jammendolia/CoolLamp/hardware/pcb/rev-a/review/CoolLamp-RevA.pdf

1 | 2 | 3 | 4 | 5 | 6 | 7 | 8
1 | 2 | 3 | 4 | 5 | 6 | 7 | 8

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
Size: A3 | Rev: A1-DRAFT | F Date: 2026-09-30
KiCad E.D.A. 10.0.6 | Id: 1/1

# Title: CoolLamp Rev A — review schematic

# File: CoolLamp-RevA.kicad_sch

# Sheet: /

# NOT FOR FABRICATION

1

1 | TP1 GPIO1 reference
5V 1 | DIN 2 | GND

# 3 J2 WS2812B strip R5

# 22R candidate R4

### 22R candidate C4

100nF | SW2 BOOT R3

10k

GPIO20_RX 1 | GPIO21_TX 2 | GND | 3 J4 UART recovery R2

10k

GND 1 +

2

SW 3 | DT | 4 CLK | 5 ENC1 HW-040 breakout | SW1 RESET
GND 1 | GND 2
3V3 3 | NC 4 | GPIO2 5 | GPIO3 6 | NC 7
EN 8 | NC 9 | NC 10 | GND 11 | GPIO0 12 | GPIO1 13 | GND 14 | NC 15 | GPIO10 16 | NC 17 | GPIO4 18 | GPIO5 19 | GPIO6 20 | GPIO7 21 | GPIO8 22 | GPIO9 23 | NC 24 | NC 25 | GPIO18 26 | GPIO19 27
NC | 28 NC | 29 GPIO20 | 30 GPIO21 | 31 NC | 32 NC | 33 NC | 34 NC | 35 GND | 36 GND | 37 GND | 38 GND | 39 GND | 40 GND | 41 GND | 42 GND | 43 GND | 44 GND | 45 GND | 46 GND | 47 GND | 48 GND | 49 GND | 50 GND | 51 GND | 52 GND | 53 U1

### ESP32-C3-MINI-1 (4MB TBD)

F1

Fuse: rating TBD

C3

10uF

3V3 1 | GND 2
SCK 3 | WS

4

SD

5 J3

### INMP441 daughterboard

VBUS 1 | D- 2 | D+ | 3 GND | 4 J1

### Existing panel USB-C

C5

# 1uF R1

10k

### PWR 1#FLG02

Supply return R6

### 10k OPTIONAL

### PWR 1#FLG01

### External 5V C2

### 1uF C1

1uF

VIN 1 | GND 2
EN 3 | NC | 4
VOUT | 5 U2

### AP2112K-3.3 candidate

R8

### 10k OPTIONAL R7

### 10k OPTIONAL

MIC_SD

USB_DP_PORT | MIC_WS MIC_SCK +3V3
GND +3V3 | ENC_SW

+3V3 GND

GND +3V3

LED_DATA_3V3 GND | +5V_SYS +5V_SYS | +3V3

USB_DP_PORT GND

USB_DP_CHIP +3V3

USB_DM_PORT +5V_SYS

USB_DM_CHIP

GND +3V3

ENC_A | BOOT_N

ENC_B

GND

GND | +3V3 GND

BOOT_STRAP8 GND

GND

GND

GND

GND

GND

GND

LED_DATA_3V3 | GND

ENC_REF_GPIO1 GND

GND

GND

ENC_A | GND MIC_SCK MIC_WS MIC_SD

BOOT_STRAP8 BOOT_N

GND

GND

GND

GND

GND USB_DM_CHIP

GND USB_DP_CHIP

CHIP_EN

GND

GND +3V3 +3V3

BOOT_N

# GND +3V3

CHIP_EN

GND

ENC_B

UART_RX

UART_TX

UART_TX

UART_RX

ENC_REF_GPIO1

ENC_SW

CHIP_EN

+3V3

GND

GND

ENC_B

GND

GND

CHIP_EN

ENC_REF_GPIO1

USB_DM_PORT | +5V_SYS

VBUS_IN

VBUS_IN

ENC_A

+5V_SYS | GND +5V_SYS

ENC_SW

# 3. USB / LED / MICROPHONE

USB ESD network still to select. No CC wires at existing inlet. 4. HW-040 ENCODER BREAKOUT

HW-040: R2/R3 10k fitted; R1 appears unpopulated. GPIO1 feeds +; CLK=GPIO4, DT=GPIO3, SW=GPIO2. Verify resistor routing / SW bias. R6-R8 remain DNP.

LED count remains configurable (1–1024 software range). Approx. 132 LEDs expected for helix; current limit is separate. Mechanical: breakout mounting stack must be remeasured. Mic board: 3.3V, local decoupling, L/R=GND. Acoustic port and mic sourcing require review. No level shifter added to prototype LED path. RELEASE BLOCKERS HW-040 header footprint, SW bias and GPIO2 boot behaviour Exact module footprint / antenna placement and mic sourcing USB ESD, input protection, inrush, current limits and thermals

## LED data margins; connector ratings; schematic/PCB review

5V / 2.4A adapter reference; LEDs share input. AP2112 loss = (5V-3.3V) x controller current. Protection/inrush and computer power budget NOT resolved.

## NOT FOR FABRICATION — encoder bias review, protection, sourcing and footprints

# COOLLAMP REV A — ELECTRICAL REVIEW DRAFT

1. POWER INPUT / 3V3 SUPPLY | 2. CONTROLLER — FIXED GPIO MAPPING
