jammendolia/CoolLamp/docs/design/assets/lamp-corkscrew.png

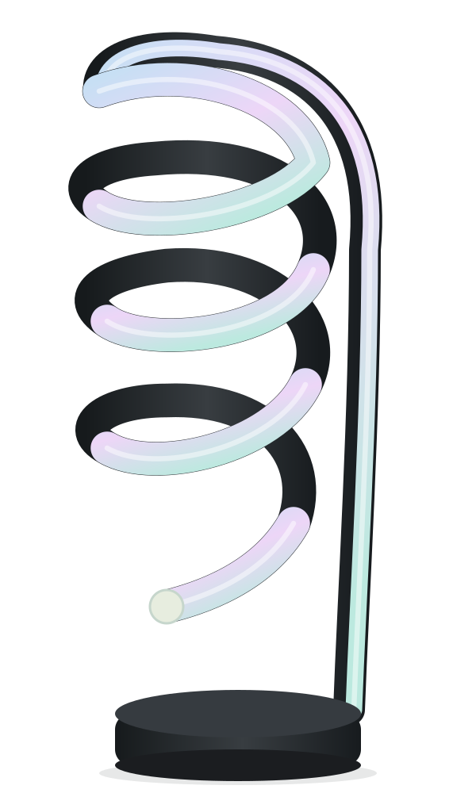
docs/design/assets/lamp-corkscrew.png
