jammendolia/CoolLamp/docs/design/assets/lamp-helix.png

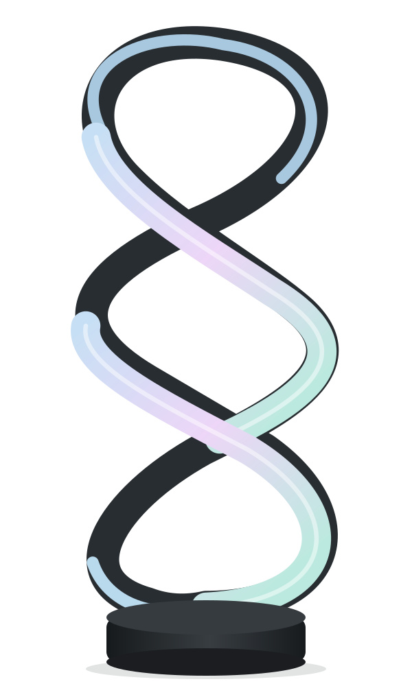
docs/design/assets/lamp-helix.png
