jammendolia/CoolLamp/docs/design/assets/lamp-knot.png

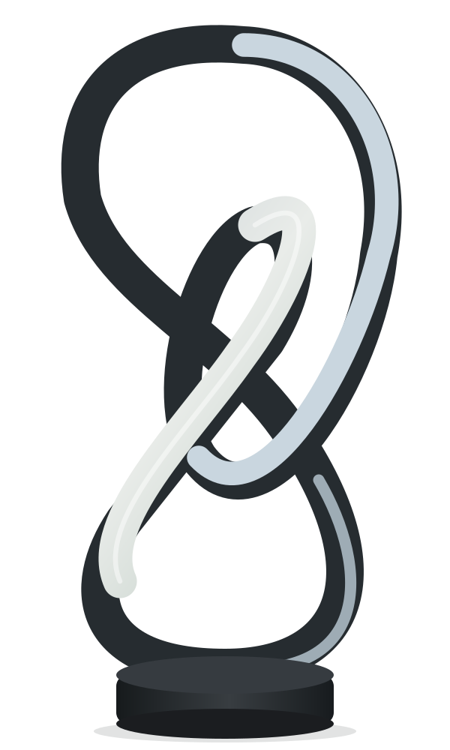
docs/design/assets/lamp-knot.png
