jammendolia/CoolLamp/docs/design/assets/lamp-large-helix.png

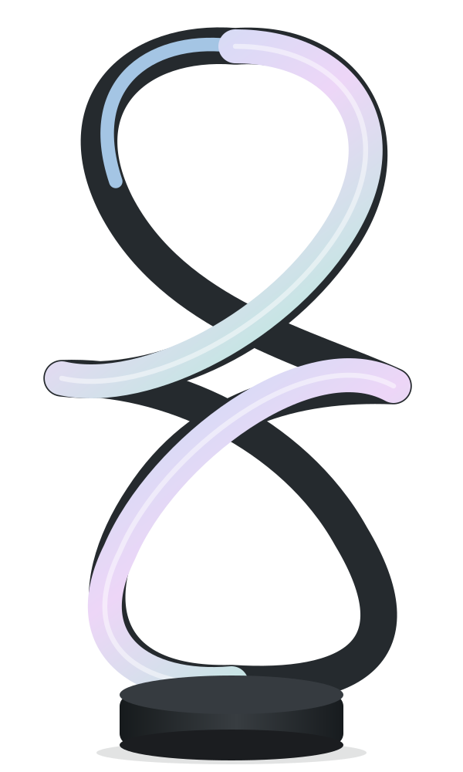
docs/design/assets/lamp-large-helix.png
