jammendolia/CoolLamp/docs/hardware/reference/hw040-front.jpg

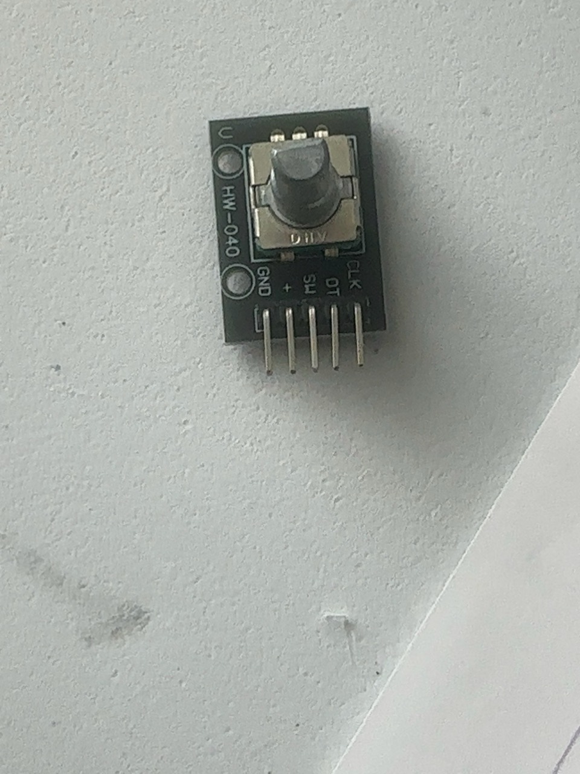
docs/hardware/reference/hw040-front.jpg
