jammendolia/CoolLamp/docs/hardware/reference/hw040-underside.jpg

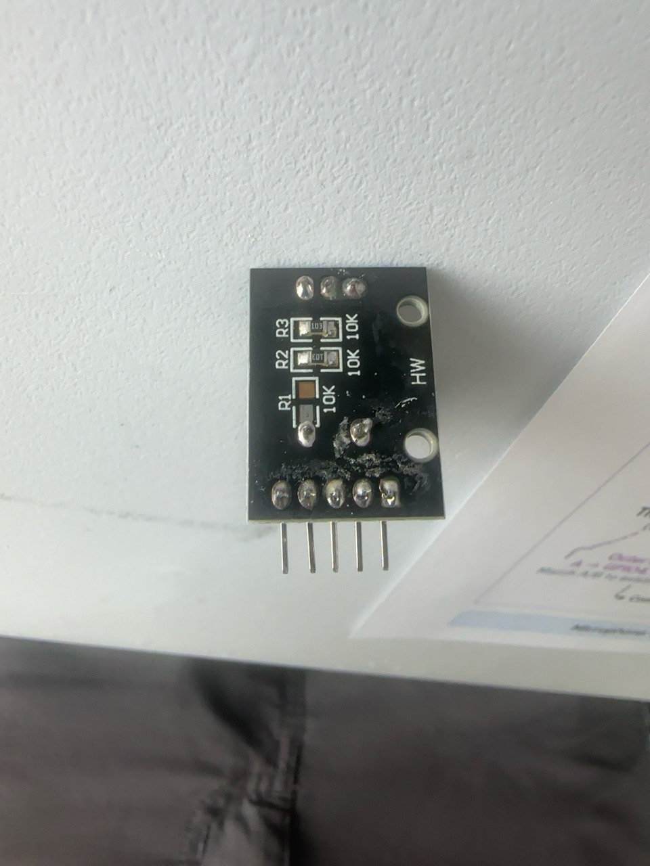
docs/hardware/reference/hw040-underside.jpg
