jammendolia/CoolLamp/docs/hardware/coollamp-microphone-encoder-wiring-prompt.md

# HW-040 wiring image — 2026-09-30

Generated using the built-in image tool, replacing the existing PNG at the user's request. Device depictions are AI-rendered from owner photographs; source photos are in `reference/hw040-front.jpg` and `reference/hw040-underside.jpg`. Pin ordering and connection labels were visually reviewed. No continuity or resistor-function measurement is claimed.

## Final prompt

Edit target: existing CoolLamp microphone + rotary encoder wiring image. Supporting reference photos: owner's HW-040 breakout top and underside. Use case: infographic-diagram. Replace the whole bare encoder lower panel with this actual HW-040 breakout: black rectangular board, silver encoder case, black shaft, two mounting holes, five header pins. Preserve upper ESP32-C3 SuperMini and round INMP441 photographic representations and their exact pinouts. Clean white print background, crisp large readable black text. Title "CoolLamp • microphone + HW-040 encoder". Subtitle "Firmware GPIO assignments preserved • September 2026".
Encoder front shown shaft toward viewer and five header pins pointing down: LEFT TO RIGHT exactly GND, +, SW, DT, CLK. Draw five unambiguous short leaders from those pins with mapping: GND → ESP GND (black), + → GPIO1 (red), SW → GPIO2 (orange), DT → GPIO3 (purple), CLK → GPIO4 (blue). Supply note "GPIO1: firmware-driven 3.3 V reference. Never connect + to 5 V." Include second small underside reference view showing R2 and R3 103 / 10K populated and R1 apparently empty. Note "R2/R3: 10 kΩ fitted. R1 appears unpopulated; verify SW pull-up." Do not invent resistors, wire onboard resistor routes, or claim continuity measured. Wiring is code-compatible assignment, not confirmed harness tracing. Short note "Match CLK/DT to existing turn direction; physical harness not traced."
Update ESP32 right-side labels GPIO4 encoder CLK, GPIO3 encoder DT, GPIO2 encoder SW, GPIO1 encoder +, GPIO0 LED DIN. Keep left top-to-bottom 5,6,7,8,9,10,20,21 and right top-to-bottom5V,GND,3V3,4,3,2,1,0. Microphone table and leaders exact: ESP3V3→VDD; GND→GND and L/R; GPIO5→SCK; GPIO6→WS; GPIO7→SD. GPIO0 LED DIN direct. Remove stale footer claiming audio firmware not implemented. Footer "Microphone: 3.3 V only • No GPIO changes • No LED level shifter". No bare-encoder contacts panel. No dark backgrounds. This is a technical wiring image; correct terminal count, ordering and leaders are more important than decorative style.
