jammendolia/CoolLamp/hardware/pcb/rev-a/CoolLamp-RevA.kicad_sch

## KiCad design hardware/pcb/rev-a/CoolLamp-RevA.kicad_sch (2026-10-06)

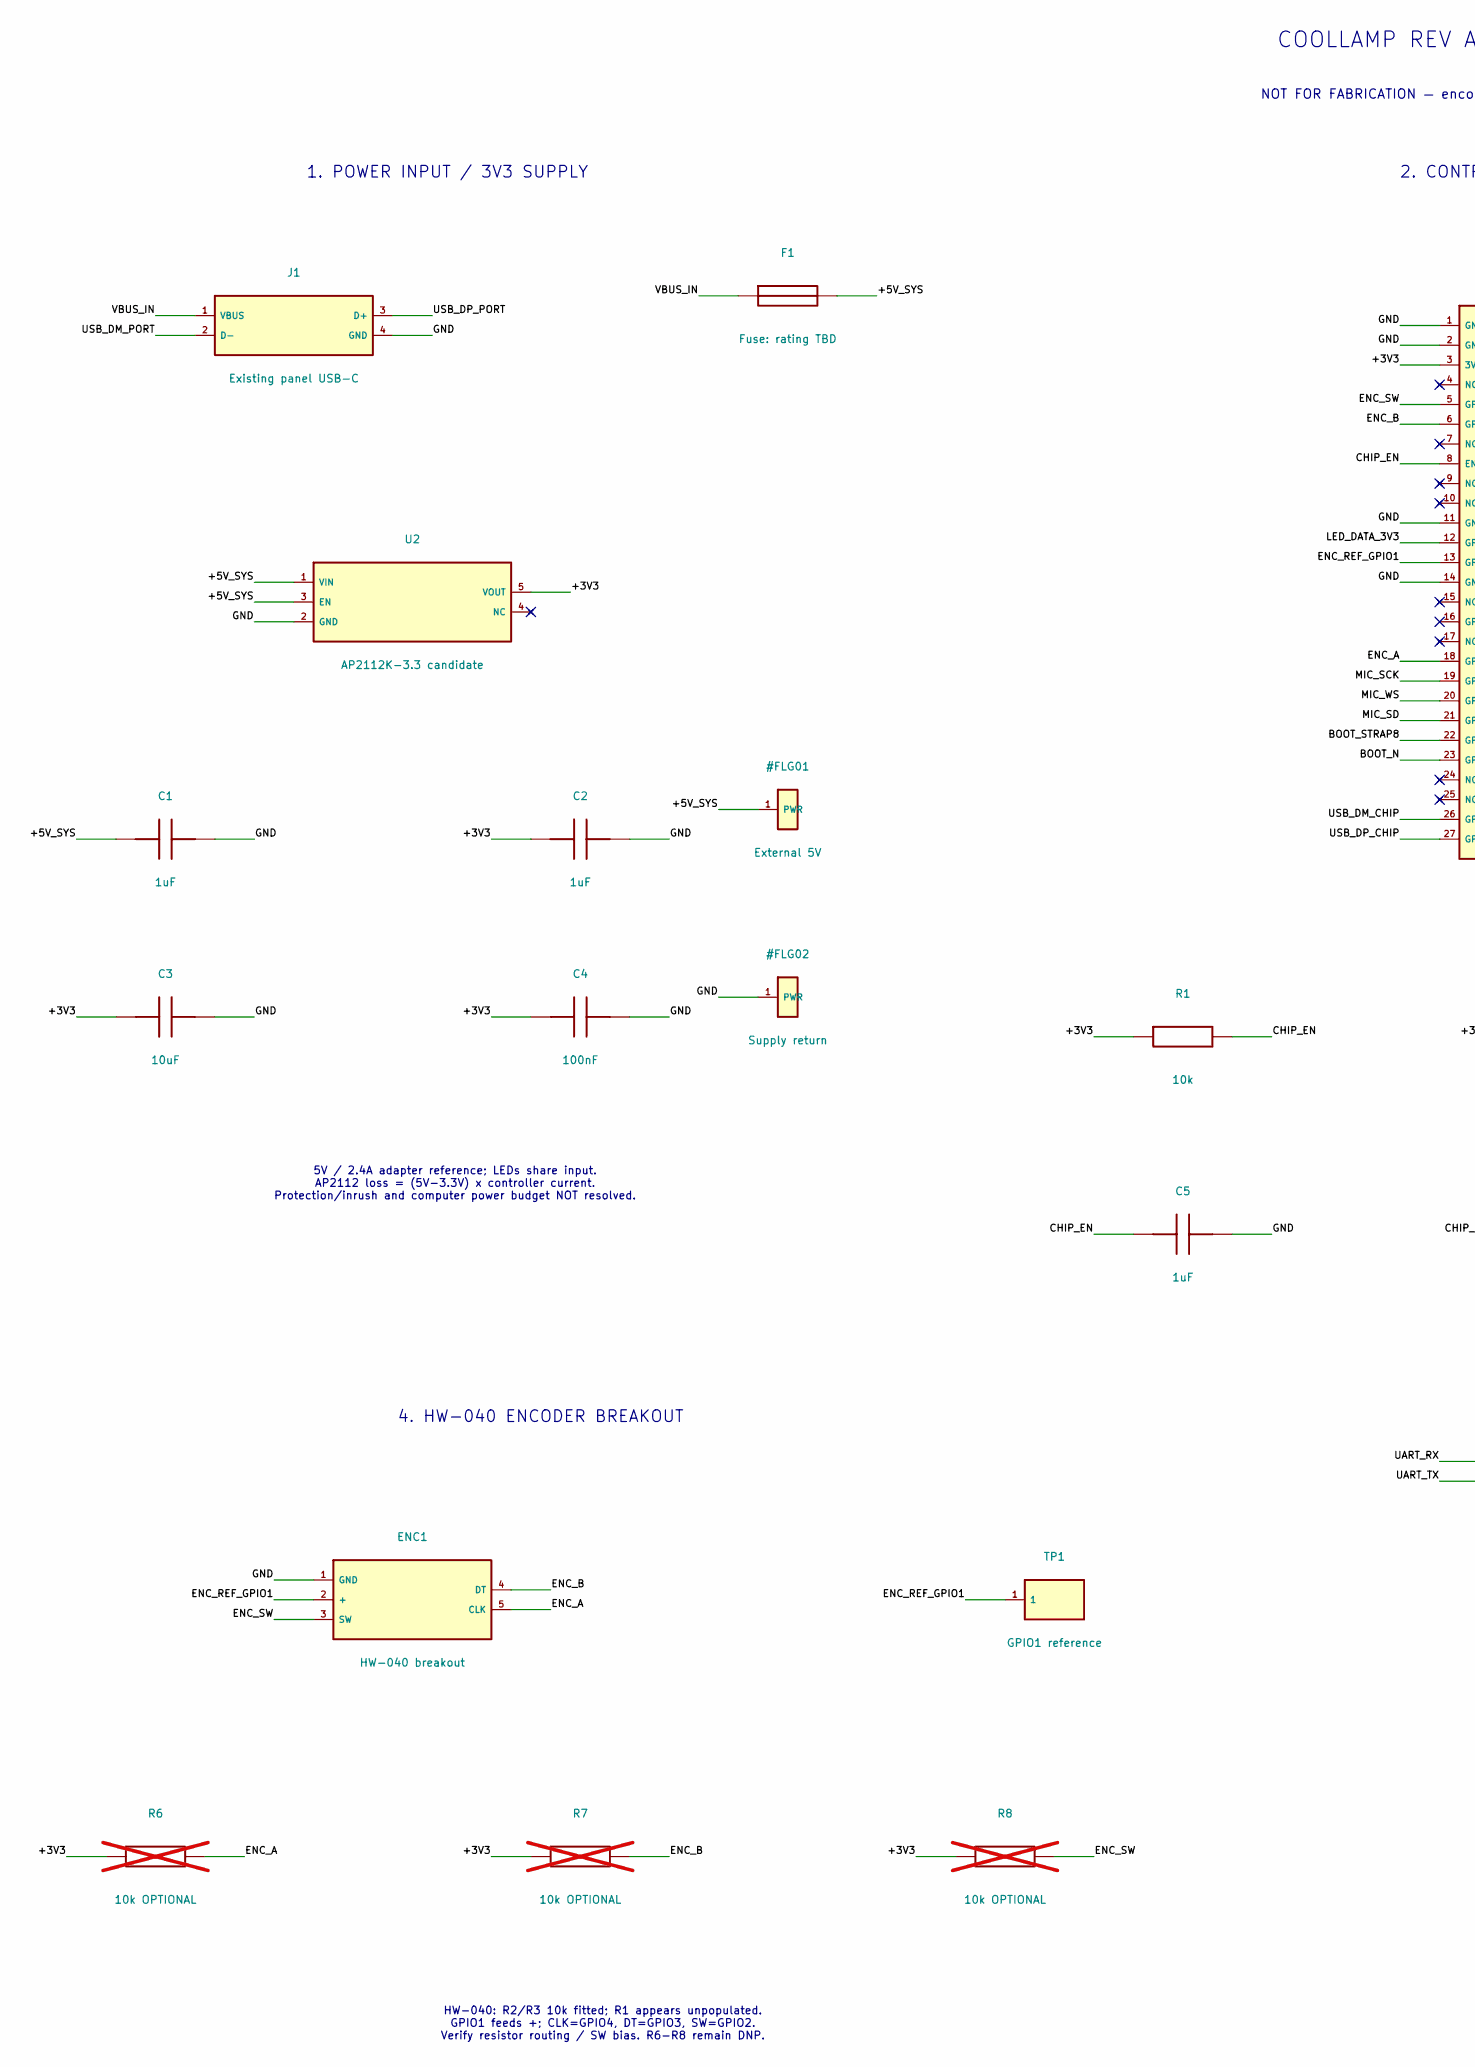
[picture p9: schematic CoolLamp-RevA.kicad_sch, part in row 1, column 1]

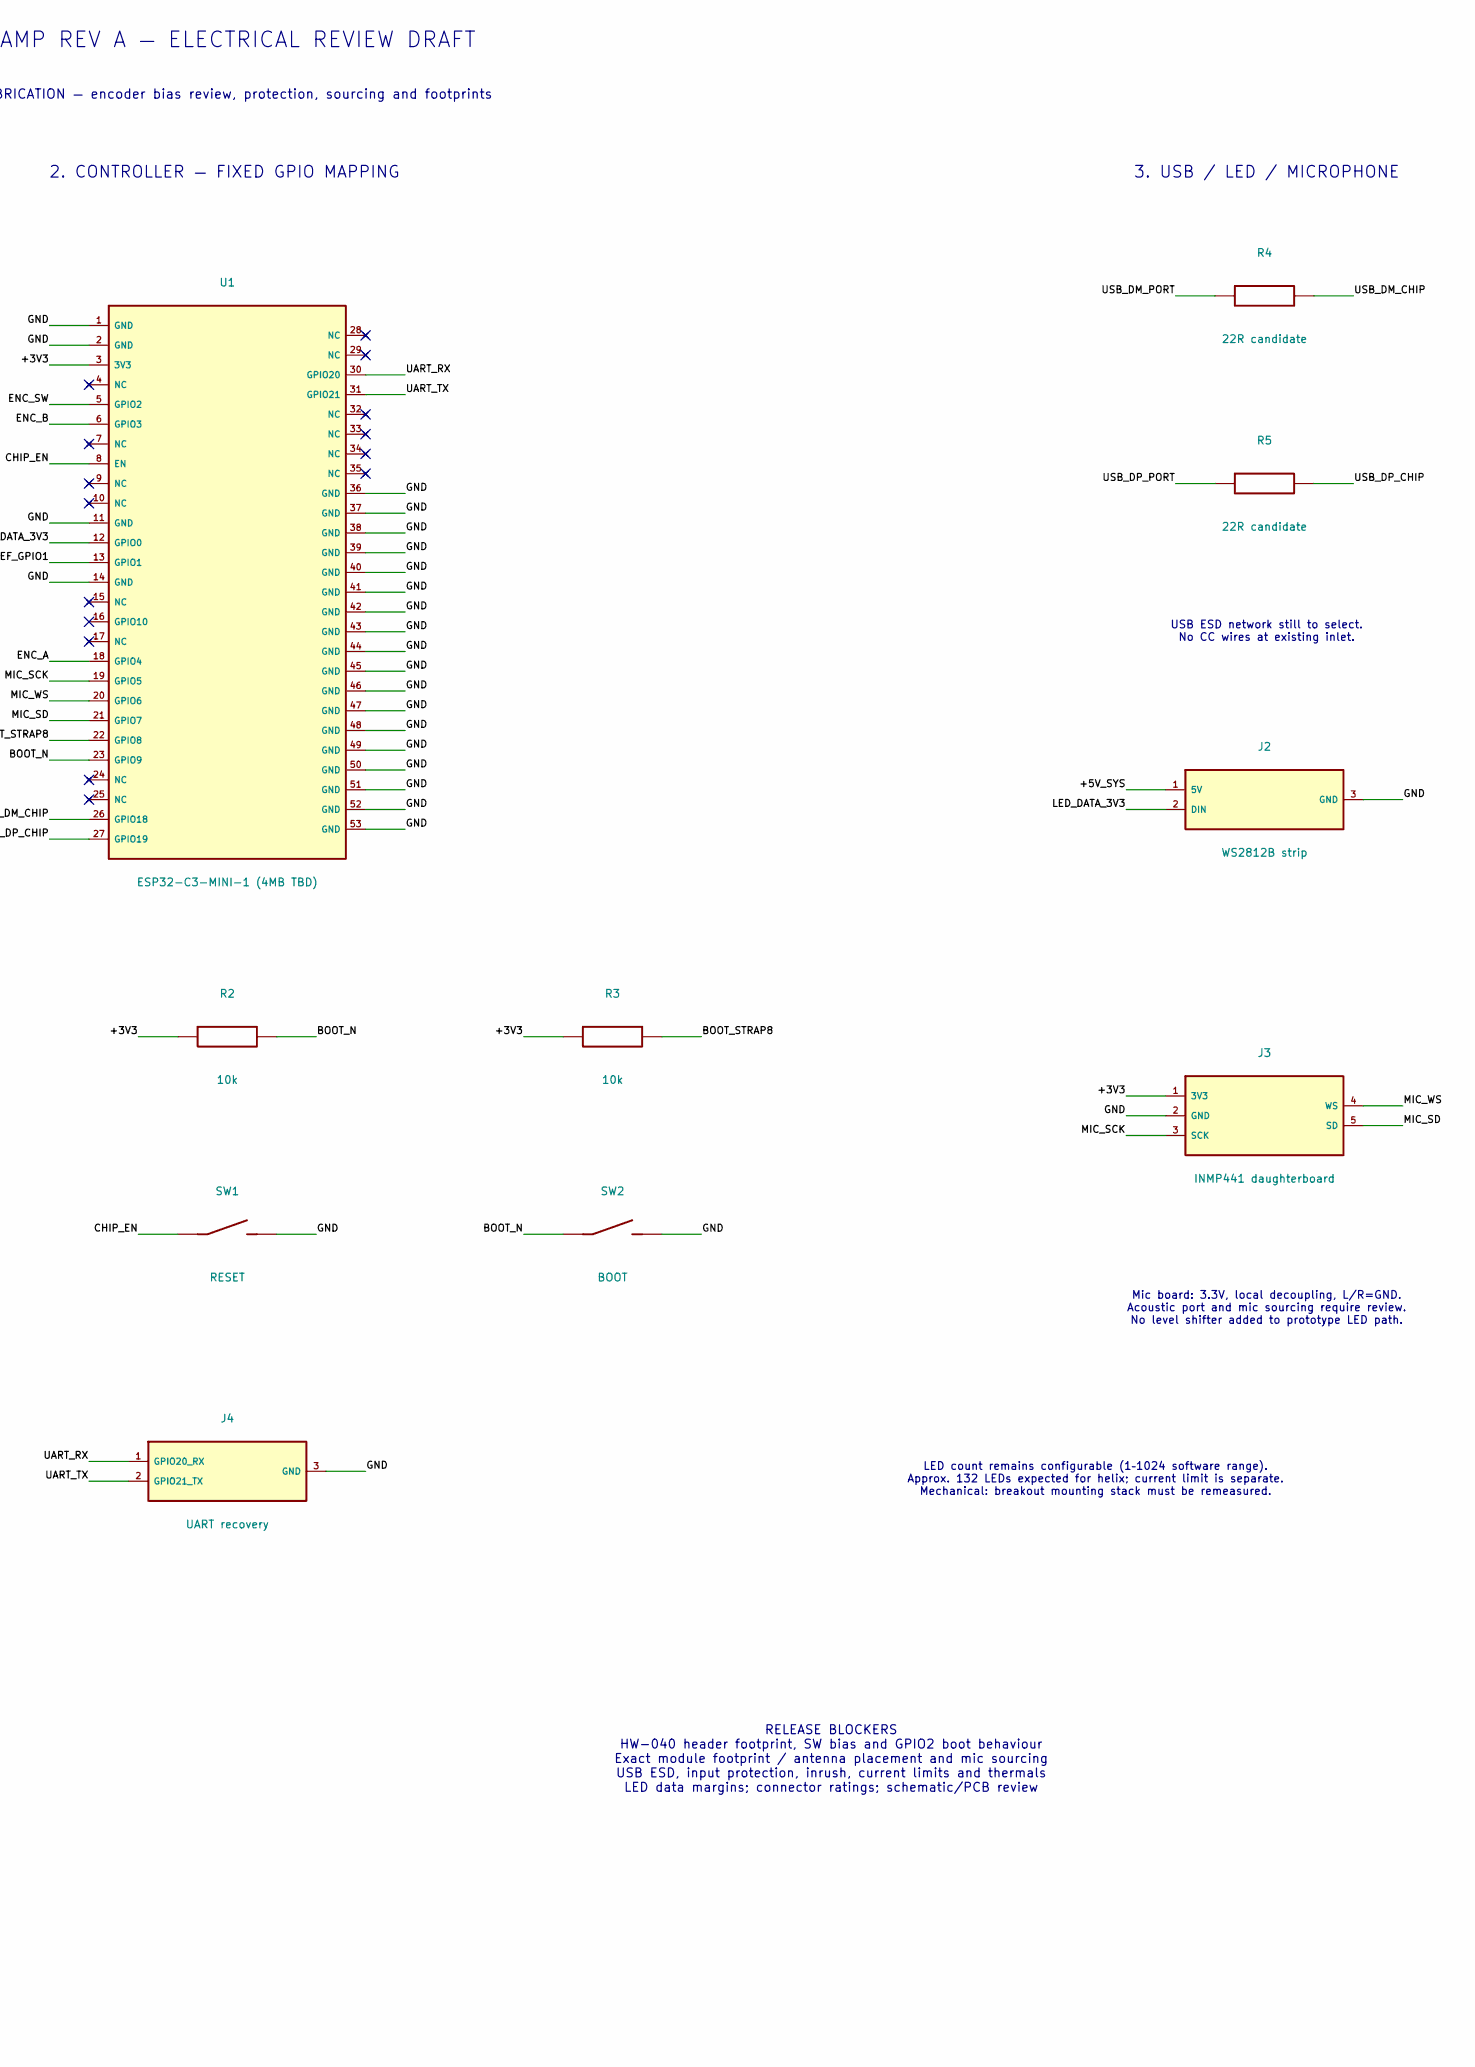
[picture p10: schematic CoolLamp-RevA.kicad_sch, part in row 1, column 2]

Parts:
C1, C2, C5: 1uF; C_0805_2012Metric
C3: 10uF; C_0805_2012Metric
C4: 100nF; C_0805_2012Metric
ENC1: HW-040 breakout
F1: Fuse: rating TBD
J1: Existing panel USB-C
J2: WS2812B strip
J3: INMP441 daughterboard
J4: UART recovery
R1, R2, R3: 10k; R_0805_2012Metric
R4, R5: 22R candidate; R_0805_2012Metric
R6, R7, R8: 10k OPTIONAL; R_0805_2012Metric; not fitted
SW1: RESET
SW2: BOOT
TP1: GPIO1 reference
U1: ESP32-C3-MINI-1 (4MB TBD)
U2: AP2112K-3.3 candidate; SOT-23-5

Connections:
+3V3: C2.1, C3.1, C4.1, J3.1 (3V3), R1.1, R2.1, R3.1, R6.1, R7.1, R8.1, U1.3 (3V3), U2.5 (VOUT)
+5V_SYS: C1.1, F1.2, J2.1 (5V), U2.1 (VIN), U2.3 (EN)
BOOT_N: R2.2, SW2.1, U1.23 (GPIO9)
BOOT_STRAP8: R3.2, U1.22 (GPIO8)
CHIP_EN: C5.1, R1.2, SW1.1, U1.8 (EN)
ENC_A: ENC1.5 (CLK), R6.2, U1.18 (GPIO4)
ENC_B: ENC1.4 (DT), R7.2, U1.6 (GPIO3)
ENC_REF_GPIO1: ENC1.2 (+), TP1.1, U1.13 (GPIO1)
ENC_SW: ENC1.3 (SW), R8.2, U1.5 (GPIO2)
GND: C1.2, C2.2, C3.2, C4.2, C5.2, ENC1.1 (GND), J1.4 (GND), J2.3 (GND), J3.2 (GND), J4.3 (GND), SW1.2, SW2.2, U1.1 (GND), U1.2 (GND), U1.11 (GND), U1.14 (GND), U1.36 (GND), U1.37 (GND), U1.38 (GND), U1.39 (GND), U1.40 (GND), U1.41 (GND), U1.42 (GND), U1.43 (GND), U1.44 (GND), U1.45 (GND), U1.46 (GND), U1.47 (GND), U1.48 (GND), U1.49 (GND), U1.50 (GND), U1.51 (GND), U1.52 (GND), U1.53 (GND), U2.2 (GND)
LED_DATA_3V3: J2.2 (DIN), U1.12 (GPIO0)
MIC_SCK: J3.3 (SCK), U1.19 (GPIO5)
MIC_SD: J3.5 (SD), U1.21 (GPIO7)
MIC_WS: J3.4 (WS), U1.20 (GPIO6)
UART_RX: J4.1 (GPIO20_RX), U1.30 (GPIO20)
UART_TX: J4.2 (GPIO21_TX), U1.31 (GPIO21)
USB_DM_CHIP: R4.2, U1.26 (GPIO18)
USB_DM_PORT: J1.2 (D-), R4.1
USB_DP_CHIP: R5.2, U1.27 (GPIO19)
USB_DP_PORT: J1.3 (D+), R5.1
VBUS_IN: F1.1, J1.1 (VBUS)

Notes on the sheet:
COOLLAMP REV A — ELECTRICAL REVIEW DRAFT
NOT FOR FABRICATION — encoder bias review, protection, sourcing and footprints
1. POWER INPUT / 3V3 SUPPLY
5V / 2.4A adapter reference; LEDs share input. AP2112 loss = (5V-3.3V) x controller current. Protection/inrush and computer power budget NOT resolved.
2. CONTROLLER — FIXED GPIO MAPPING
3. USB / LED / MICROPHONE
USB ESD network still to select. No CC wires at existing inlet.
Mic board: 3.3V, local decoupling, L/R=GND. Acoustic port and mic sourcing require review. No level shifter added to prototype LED path.
4. HW-040 ENCODER BREAKOUT
HW-040: R2/R3 10k fitted; R1 appears unpopulated. GPIO1 feeds +; CLK=GPIO4, DT=GPIO3, SW=GPIO2. Verify resistor routing / SW bias. R6-R8 remain DNP.
RELEASE BLOCKERS HW-040 header footprint, SW bias and GPIO2 boot behaviour Exact module footprint / antenna placement and mic sourcing USB ESD, input protection, inrush, current limits and thermals LED data margins; connector ratings; schematic/PCB review
LED count remains configurable (1–1024 software range). Approx. 132 LEDs expected for helix; current limit is separate. Mechanical: breakout mounting stack must be remeasured.
