jammendolia/CoolLamp/LampNetwork.ino

#include <WiFi.h>
#include <esp_wifi.h>
#include <WebServer.h>
#include <ESPmDNS.h>
#include <Preferences.h>
#include <Update.h>
#include <esp_app_format.h>
#include <esp_app_desc.h>
#include "LampFactory.h"
#include "LampPage.h"
#include "LampWifiSetup.h"
#include "LampControlHttpAdapter.h"
#include "LampWifiRecoveryPolicy.h"
#include "LampStyle.h"
#include "LampMeshAdapter.h"
#include "LampCommission.h"

LampSettings lampSettings;
LampControlHttpAdapter lampServer(80);
String lampHost;
String lampName;
uint32_t identifyUntil = 0;
bool lampIdentifyActive() { return identifyUntil && static_cast<int32_t>(identifyUntil - millis()) > 0; }
String lampAPName;
String lampToken;
bool scanActive = false;
uint32_t scanStartedAt = 0;
uint32_t scanDuration = 0;
uint32_t scanPolls = 0;
int scanCount = WIFI_SCAN_FAILED;
String scanResults = "{\"status\":\"idle\",\"networks\":[]}";
bool setupAP = false;
bool lastAPStartOK = false;
bool serverStarted = false;
bool mdnsStarted = false;
bool otaActive = false;
bool otaAccepted = false;
bool otaComplete = false;
bool lampMeshEnrollmentEligible(){
  uint8_t key[16]{};
  const bool paired=LampFirmwareRelay::copyFleetKey(key);
  volatile uint8_t* clear=key;for(unsigned i=0;i<16;++i)clear[i]=0;
  return !paired&&!lampSettings.ssid[0]&&!lampBluetoothHasBonds()&&lampSyncRole()==0&&
    !setupAP&&!scanActive&&!lampPairingOpen()&&!lampWifiSetupBusy()&&!lampUpdateOwnsResources()&&
    !lampFactoryResetPending()&&!lampFactoryResetArmed()&&!lampCalibrationActive();
}
uint32_t apLastActivity = 0;
uint32_t setupPulseStart = 0;
bool setupPulseActive = false;
uint32_t restartAt = 0;
uint32_t otaLastActivity = 0;
String otaMessage;
constexpr size_t IMAGE_PREFIX_SIZE = sizeof(esp_image_header_t) + sizeof(esp_image_segment_header_t) + sizeof(esp_app_desc_t);
uint8_t imagePrefix[IMAGE_PREFIX_SIZE];
size_t imagePrefixUsed = 0;
bool imageValidated = false;

const char* const effectNames[] = {
  "Pacifica", "Aurora", "Rain", "Fire", "Split fire - rising", "Split fire - falling",
  "Split fire - rising, reversed colors", "Blue gas fire", "Witch fire", "Purple fire",
  "Embers", "Lava", "Plasma", "Rainbow", "Rainbow with glitter", "Confetti",
  "Comet collision", "Sinelon", "BPM", "Juggle", "White", "Red", "Green",
  "Blue", "Purple", "Pink", "Yellow", "Cyan", "Custom solid",
  "Bouncing droplets - rising", "Lightning storm", "Color tide", "Fireflies", "Heartbeat", "Shooting stars", "Breathing glow", "Lava blobs", "Bouncing droplets - falling", "Sound glow", "Sound meter", "Spectrum Rise", "Bass Launch", "Spectral Embers", "Beat Bloom", "Three-band Fountain", "VU Meter", "Rainbow Embers"
};
static_assert(sizeof(effectNames) / sizeof(effectNames[0]) == MODE_MAX, "Every mode needs a web label");

void loadLampSettings()
{
  LampSettings defaults = {};
  defaults.version = 1;
  defaults.ledCount = DEFAULT_LED_COUNT;
  defaults.milliAmps = MAX_POWER_MILLIAMPS;
  defaults.brightness = 100;
  defaults.startupMode = MODE_FIRE;
  strlcpy(defaults.adminPassword, LAMP_FACTORY_PASSWORD, sizeof(defaults.adminPassword));
  lampSettings = defaults;
  Preferences prefs;
  if (!prefs.begin("coollamp", true)) return;
  LampSettings saved = {};
  const bool found = prefs.getBytesLength("settings") == sizeof(saved) &&
                     prefs.getBytes("settings", &saved, sizeof(saved)) == sizeof(saved);
  prefs.end();
  if (!found || saved.version != 1 || saved.ledCount < 1 || saved.ledCount > MAX_LED_COUNT ||
      saved.milliAmps < 100 || saved.milliAmps > 20000 || saved.brightness < 1 ||
      saved.startupMode < 1 || saved.startupMode > MODE_MAX ||
      saved.ssid[32] != '\0' || saved.wifiPassword[63] != '\0' || saved.adminPassword[63] != '\0' ||
      strlen(saved.adminPassword) < 8) return;
  lampSettings = saved;
}

String jsonText(const String& value)
{
  String out = "\"";
  for (size_t i = 0; i < value.length(); i++) {
    const uint8_t c = value[i];
    if (c == '"' || c == '\\') { out += '\\'; out += static_cast<char>(c); }
    else if (c < 32) { char escape[7]; snprintf(escape, sizeof(escape), "\\u%04x", c); out += escape; }
    else out += static_cast<char>(c);
  }
  return out + '"';
}

bool authorizedLampRequest(bool mutation)
{
  lampServer.sendHeader("Cache-Control", "no-store");
  if (!lampServer.authenticate("lamp", lampSettings.adminPassword)) {
    lampServer.requestAuthentication();
    return false;
  }
  if (mutation && lampServer.header("X-Lamp-Token") != lampToken) {
    lampServer.send(403, "text/plain", "Refresh the page and try again.");
    return false;
  }
  if(mutation && lampSyncFollowing()) {
    const String path=lampServer.uri();
    if(path=="/api/preview"||path=="/api/color"||path=="/api/effect-options"||path=="/api/defaults"||path=="/api/config"||path=="/api/vu-colors"||path=="/api/fountain-colors"||path=="/api/audio/tuning") {
      lampServer.send(409,"text/plain","This lamp is following a group. Edit the coordinator or pause grouping first.");return false;
    }
  }
  apLastActivity = millis();
  return true;
}

// Scan asynchronously so effects and HTTP requests continue while the radio scans.
void serviceLampScan()
{
  if (!scanActive) return;
  const int count = WiFi.scanComplete();
  if (count == WIFI_SCAN_RUNNING) return;
  scanActive = false;
  scanCount = count;
  scanDuration = millis() - scanStartedAt;
  if (count < 0) {
    esp_wifi_scan_stop();
    scanResults = "{\"status\":\"failed\",\"networks\":[]}";
  } else {
    // WiFi exposes result indexes as uint8_t. Bound both work and response size.
    int selected[32];
    int used = 0;
    for (int i = 0; i < count && i < 256; ++i) {
      const String ssid = WiFi.SSID(i);
      if (ssid.isEmpty()) continue;
      bool duplicate = false;
      for (int j = 0; j < used; ++j) {
        if (WiFi.SSID(selected[j]) == ssid && WiFi.encryptionType(selected[j]) == WiFi.encryptionType(i)) {
          if (WiFi.RSSI(i) > WiFi.RSSI(selected[j])) selected[j] = i;
          duplicate = true; break;
        }
      }
      if (duplicate) continue;
      if (used < 32) selected[used++] = i;
      else {
        int weakest = 0;
        for (int j = 1; j < used; ++j) if (WiFi.RSSI(selected[j]) < WiFi.RSSI(selected[weakest])) weakest = j;
        if (WiFi.RSSI(i) > WiFi.RSSI(selected[weakest])) selected[weakest] = i;
      }
    }
    for (int i = 0; i < used; ++i) for (int j = i + 1; j < used; ++j) {
      if (WiFi.RSSI(selected[j]) > WiFi.RSSI(selected[i])) { int swap = selected[i]; selected[i] = selected[j]; selected[j] = swap; }
    }
    scanResults = "{\"status\":\"complete\",\"networks\":[";
    for (int i = 0; i < used; ++i) {
      if (i) scanResults += ',';
      const int index = selected[i];
      captureLampWifiSetupNetwork(i, WiFi.SSID(index), WiFi.RSSI(index), WiFi.encryptionType(index) == WIFI_AUTH_OPEN);
      scanResults += "{\"ssid\":" + jsonText(WiFi.SSID(index));
      scanResults += ",\"rssi\":" + String(WiFi.RSSI(index));
      scanResults += ",\"open\":" + String(WiFi.encryptionType(index) == WIFI_AUTH_OPEN ? "true" : "false") + "}";
    }
    scanResults += "]}";
  }
  WiFi.scanDelete();
  finishLampWifiSetupScan(count >= 0);
}

void beginLampScan()
{
  if (!scanActive) {
    scanStartedAt = millis(); scanDuration = 0; scanPolls = 0;
    WiFi.setScanTimeout(20000);
    scanCount = WiFi.scanNetworks(true, false, false, 120);
    scanActive = scanCount == WIFI_SCAN_RUNNING;
    scanResults = scanActive ? "{\"status\":\"scanning\",\"networks\":[]}" : "{\"status\":\"failed\",\"networks\":[]}";
  }
}

void startLampScan()
{
  if (!authorizedLampRequest(true)) return;
  if (otaActive || lampRemoteUpdateBusy() || lampWifiSetupBusy() || lampFactoryResetPending()) { lampServer.send(409, "text/plain", "Wait for the firmware update, reset or Bluetooth Wi-Fi setup to finish."); return; }
  beginLampScan();
  lampServer.send(202, "application/json", scanResults);
}

bool readNumber(const char* name, uint32_t low, uint32_t high, uint32_t& result)
{
  const String value = lampServer.arg(name);
  if (value.isEmpty() || value.length() > 6) return false;
  result = 0;
  for (size_t i = 0; i < value.length(); i++) {
    if (value[i] < '0' || value[i] > '9') return false;
    result = result * 10 + value[i] - '0';
  }
  return result >= low && result <= high;
}

String lampEffectCatalogEntry(uint8_t mode)
{
  if (mode < 1 || mode > lampAvailableEffectCount()) return "{}";
  const bool calm = mode == 1 || mode == 2 || mode == 3 || mode == 13 || mode == 30 || mode == 32 || mode == 33 || mode >= 36;
  const char* category = mode > LAMP_BASE_EFFECT_COUNT ? "audio" : mode >= 4 && mode <= 12 ? "fire" : calm ? "calm" : "color";
  return "{\"id\":" + String(mode) + ",\"name\":" + jsonText(effectNames[mode-1]) +
    ",\"category\":" + jsonText(category) + ",\"speed\":" + String(mode >= 21 && mode <= 29 ? "false" : "true") + "}";
}

// Read-only support snapshot. Deliberately excludes session tokens, SSIDs,
// passwords, group invitation keys and raw microphone samples.
String lampDiagnosticsJson()
{
  const bool connected = WiFi.status() == WL_CONNECTED;
  wifi_ps_type_t sleepMode = WIFI_PS_NONE;
  const int powerSave = esp_wifi_get_ps(&sleepMode) == ESP_OK ? static_cast<int>(sleepMode) : -1;
  String out = "{\"diagnosticsVersion\":1,\"deviceId\":" + jsonText(lampIdentity());
  out += ",\"hostname\":" + jsonText(lampHost + ".local");
  out += ",\"uptimeMs\":" + String(millis()) + ",\"resetReason\":" + String(static_cast<int>(esp_reset_reason()));
  out += ",\"freeHeap\":" + String(ESP.getFreeHeap()) + ",\"minFreeHeap\":" + String(ESP.getMinFreeHeap());
  out += ",\"largestFreeBlock\":" + String(ESP.getMaxAllocHeap());
  out += ",\"chipTemperature\":" + lampTemperatureJson();
  out += ",\"wifi\":{\"connected\":" + String(connected ? "true" : "false");
  out += ",\"address\":" + jsonText(WiFi.localIP().toString());
  out += ",\"rssi\":" + String(connected ? WiFi.RSSI() : 0) + ",\"channel\":" + String(WiFi.channel());
  out += ",\"powerSave\":" + String(powerSave);
  out += ",\"accessPoint\":" + jsonText(connected ? WiFi.BSSIDstr() : String());
  out += ",\"subnet\":" + jsonText(WiFi.subnetMask().toString()) + ",\"gateway\":" + jsonText(WiFi.gatewayIP().toString());
  out += ",\"setupAP\":" + String(setupAP ? "true" : "false") + ",\"apClients\":" + String(WiFi.softAPgetStationNum()) + "}";
  out += ",\"scan\":{\"active\":" + String(scanActive ? "true" : "false") + ",\"count\":" + String(scanCount);
  out += ",\"durationMs\":" + String(scanActive ? millis() - scanStartedAt : scanDuration) + ",\"polls\":" + String(scanPolls) + "}";
  out += ",\"render\":{\"frames\":" + String(lampRenderedFrames) + ",\"maxRenderUs\":" + String(lampMaxRenderUs);
  out += ",\"power\":" + String(PowerOn ? "true" : "false") + ",\"mode\":" + String(Mode) + ",\"brightness\":" + String(Brightness);
  out += ",\"leds\":" + String(NUM_LEDS) + ",\"midpoint\":" + String(lampMidpoint) + "}";
  out += ",\"firmware\":" + lampUpdateJson() + ",\"audio\":" + lampAudioJson() + ",\"sync\":" + lampSyncJson();
  out += ",\"lampStyle\":" + lampStyleJson() + "}";
  return out;
}
void sendLampDiagnostics()
{
  if (!authorizedLampRequest(false)) return;
  lampServer.send(200, "application/json", lampDiagnosticsJson());
}

void sendLampState()
{
  if (!authorizedLampRequest(false)) return;
  String state = "{\"deviceId\":" + jsonText(lampIdentity());
  if(!lampServer.controlActive())state += ",\"token\":" + jsonText(lampToken);
  state += ",\"name\":" + jsonText(lampName) + ",\"uptimeMs\":" + String(millis());
  state += ",\"controlVersion\":1";
  state += ",\"apiVersion\":2,\"startupMode\":" + String(lampSettings.startupMode <= lampAvailableEffectCount() ? lampSettings.startupMode : MODE_FIRE) + ",\"startupBrightness\":" + String(lampSettings.brightness);
  state += ",\"catalogVersion\":1";
  state += ",\"factoryReset\":true";
  state += ",\"usingDefaultPassword\":" + String(lampUsesFactoryPassword(lampSettings.adminPassword) ? "true" : "false");
  state += ",\"protocol\":" + String(LAMP_PROTOCOL_VERSION);
  state += ",\"firmware\":" + lampUpdateJson();
  state += ",\"audio\":" + lampAudioJson();
  state += ",\"sync\":" + lampSyncJson();
  state += ",\"lampStyle\":" + lampStyleJson();
  state += ",\"calibration\":{\"active\":"+String(lampCalibrationActive()?"true":"false")+",\"position\":"+String(lampCalibrationPosition())+",\"kind\":\""+(lampCalibrationCenter()?"center":"leds")+"\",\"centerSupported\":true}";
  state += ",\"rotation\":{\"enabled\":"+String(lampRotation.enabled?"true":"false")+",\"random\":"+String(lampRotation.random?"true":"false")+",\"category\":"+String(lampRotation.category)+",\"seconds\":"+String(lampRotation.seconds)+"}";
  state += ",\"fountainColors\":[";
  for(unsigned i=0;i<3;++i){if(i)state+=',';const auto c=fountainPaletteColor(i);state+="["+String(c.r)+","+String(c.g)+","+String(c.b)+"]";}
  state += "]";
  state += ",\"vuColors\":[";
  for(unsigned i=0;i<3;++i){if(i)state+=',';const auto c=renderVuColor(i);state+="["+String(c.r)+","+String(c.g)+","+String(c.b)+"]";}
  state += "]";
  state += ",\"midpoint\":" + String(lampMidpoint) + ",\"effectiveMidpoint\":" + String(lampSplitCount(NUM_LEDS, lampMidpoint));
  state += ",\"mode\":" + String(Mode) + ",\"brightness\":" + String(Brightness);
  state += ",\"leds\":" + String(NUM_LEDS) + ",\"milliamps\":" + String(lampSettings.milliAmps);
  state += ",\"power\":" + String(PowerOn ? "true" : "false");
  state += ",\"ssid\":" + jsonText(lampSettings.ssid);
  state += ",\"connected\":" + String(WiFi.status() == WL_CONNECTED ? "true" : "false");
  state += ",\"address\":" + jsonText(WiFi.localIP().toString());
  state += ",\"gateway\":" + jsonText(WiFi.gatewayIP().toString());
  state += ",\"dns\":[" + jsonText(WiFi.dnsIP(0).toString()) + "," + jsonText(WiFi.dnsIP(1).toString()) + "]";
  state += ",\"hostname\":" + jsonText(lampHost + ".local") + ",\"effects\":[";
  for (size_t i = 0; i < lampAvailableEffectCount(); i++) { if (i) state += ','; state += jsonText(effectNames[i]); }
  state += "],\"colors\":[";
  for (uint8_t mode = 1; mode <= lampAvailableEffectCount(); ++mode) {
    if (mode > 1) state += ',';
    const auto c = getLampColor(mode);
    state += "[" + String(c.enabled) + "," + String(c.r) + "," + String(c.g) + "," + String(c.b) + "]";
  }
  state += "],\"effectOptions\":[";
  for (uint8_t mode=1;mode<=lampAvailableEffectCount();++mode) {
    if(mode>1) state+=','; const auto o=getLampEffectOptions(mode);
    state += "["+String(o.speed)+","+String(o.intensity)+","+String(o.dual)+","+String(o.r)+","+String(o.g)+","+String(o.b)+"]";
  }
  state += "]}";
  lampServer.send(200, "application/json", state);
}

LampControlReply lampControlRequest(uint8_t endpoint,bool mutation,const String& form) {
  return lampServer.executeControl(endpoint,mutation,form);
}
String lampControlSnapshotJson() {
  auto response=lampControlRequest(LampControlEndpoint::State,false,String());
  return response.status==200?std::move(response.body):String("{}");
}

void saveLampConfiguration()
{
  if (!authorizedLampRequest(true)) return;
  if (otaActive || lampRemoteUpdateBusy() || lampWifiSetupBusy()) { lampServer.send(409, "text/plain", "Wait for the firmware update or Bluetooth Wi-Fi setup to finish."); return; }
  uint32_t count, powerLimit, brightness, mode;
  if (!readNumber("leds", 1, MAX_LED_COUNT, count) || !readNumber("milliamps", 100, 20000, powerLimit) ||
      !readNumber("brightness", 1, 255, brightness) || !readNumber("mode", 1, lampAvailableEffectCount(), mode)) {
    lampServer.send(400, "text/plain", "Check LED count, power limit, brightness, and effect."); return;
  }
  LampSettings next = lampSettings;
  uint32_t microphone=0;
  const bool updateMicrophone=lampServer.hasArg("microphoneInstalled");
  if(updateMicrophone&&!readNumber("microphoneInstalled",0,1,microphone)){lampServer.send(400,"text/plain","Choose whether a microphone is installed.");return;}
  next.ledCount = count; next.milliAmps = powerLimit; next.brightness = brightness; next.startupMode = mode;
  const String ssid = lampServer.hasArg("ssid") ? lampServer.arg("ssid") : String(next.ssid);
  const String wifiPass = lampServer.arg("wifiPassword");
  const String adminPass = lampServer.arg("adminPassword");
  if (ssid.length() > 32 || wifiPass.length() > 63 || (!wifiPass.isEmpty() && wifiPass.length() < 8) ||
      (!adminPass.isEmpty() && (adminPass.length() < 8 || adminPass.length() > 63))) {
    lampServer.send(400, "text/plain", "Wi-Fi passwords need 8–63 characters; access passwords need 8–63. Network names are at most 32 bytes."); return;
  }
  if (lampServer.arg("forgetWifi") == "1") {
    memset(next.ssid, 0, sizeof(next.ssid)); memset(next.wifiPassword, 0, sizeof(next.wifiPassword));
  } else if(lampServer.hasArg("ssid") || !wifiPass.isEmpty() || lampServer.arg("openNetwork") == "1") {
    if (ssid != String(next.ssid) && !ssid.isEmpty() && wifiPass.isEmpty() && lampServer.arg("openNetwork") != "1") {
      lampServer.send(400, "text/plain", "Enter the new network password or select the password-free network option."); return;
    }
    memset(next.ssid, 0, sizeof(next.ssid)); strlcpy(next.ssid, ssid.c_str(), sizeof(next.ssid));
    if (ssid.isEmpty() || lampServer.arg("openNetwork") == "1") memset(next.wifiPassword, 0, sizeof(next.wifiPassword));
    else if (!wifiPass.isEmpty()) { memset(next.wifiPassword, 0, sizeof(next.wifiPassword)); strlcpy(next.wifiPassword, wifiPass.c_str(), sizeof(next.wifiPassword)); }
  }
  if (!adminPass.isEmpty()) { memset(next.adminPassword, 0, sizeof(next.adminPassword)); strlcpy(next.adminPassword, adminPass.c_str(), sizeof(next.adminPassword)); }
  Preferences prefs;
  if (!prefs.begin("coollamp", false)) { lampServer.send(500, "text/plain", "Could not open saved settings. Nothing changed."); return; }
  const bool previousMicrophone=lampHasMicrophone();
  if(updateMicrophone&&!saveLampMicrophoneInstalled(microphone)){prefs.end();lampServer.send(500,"text/plain","Could not save microphone settings. Configuration was not changed.");return;}
  const bool saved = prefs.putBytes("settings", &next, sizeof(next)) == sizeof(next);
  prefs.end();
  if (!saved) {const bool restored=!updateMicrophone||saveLampMicrophoneInstalled(previousMicrophone);lampServer.send(500,"text/plain",restored?"Settings could not be saved. Nothing changed.":"Settings could not be saved and microphone rollback was not confirmed. Read the lamp settings before retrying.");return;}
  if (!saveLampColors()) { lampServer.send(500, "text/plain", "Settings saved, but colors could not be saved. Please retry."); return; }
  lampServer.send(200, "text/plain", "Saved. Restarting… If needed, hold the knob for three seconds to reopen setup. On home Wi-Fi, use http://" + lampHost + ".local/");
  restartAt = millis() + 1200;
}

void failLampUpdate(const String& message)
{
  if (Update.isRunning()) Update.abort();
  releaseLampManualUpdate();
  otaAccepted = false; otaActive = false; otaComplete = false; otaMessage = message;
}

void receiveLampUpdate()
{
  HTTPUpload& upload = lampServer.upload();
  if (upload.status == UPLOAD_FILE_START) {
    otaComplete = false; otaAccepted = false; otaMessage = "Update did not finish.";
    imagePrefixUsed = 0; imageValidated = false;
    if (!lampServer.authenticate("lamp", lampSettings.adminPassword) || lampServer.header("X-Lamp-Token") != lampToken) {
      otaMessage = "Not authorized. Refresh the setup page and sign in."; return;
    }
    if (!reserveLampManualUpdate()) { otaMessage = "Another update operation is active. Try again when it finishes."; return; }
    otaAccepted = true; otaActive = true; otaLastActivity = millis();
  } else if (upload.status == UPLOAD_FILE_WRITE && otaAccepted) {
    otaLastActivity = millis();
    size_t offset = 0;
    if (!imageValidated) {
      const size_t needed = IMAGE_PREFIX_SIZE - imagePrefixUsed;
      const size_t take = upload.currentSize < needed ? upload.currentSize : needed;
      memcpy(imagePrefix + imagePrefixUsed, upload.buf, take);
      imagePrefixUsed += take; offset += take;
      if (imagePrefixUsed < IMAGE_PREFIX_SIZE) return;
      esp_image_header_t header; esp_app_desc_t app;
      memcpy(&header, imagePrefix, sizeof(header));
      memcpy(&app, imagePrefix + sizeof(header) + sizeof(esp_image_segment_header_t), sizeof(app));
      if (header.magic != ESP_IMAGE_HEADER_MAGIC || header.chip_id != CONFIG_IDF_FIRMWARE_CHIP_ID || app.magic_word != ESP_APP_DESC_MAGIC_WORD) {
        failLampUpdate("Choose an ESP32-C3 application .ino.bin file, not a bootloader or merged image."); return;
      }
      if (!Update.begin(UPDATE_SIZE_UNKNOWN, U_FLASH)) { failLampUpdate("Cannot start update: " + String(Update.errorString())); return; }
      imageValidated = true;
      if (Update.write(imagePrefix, IMAGE_PREFIX_SIZE) != IMAGE_PREFIX_SIZE) { failLampUpdate("Could not write firmware header."); return; }
    }
    if (offset < upload.currentSize && Update.write(upload.buf + offset, upload.currentSize - offset) != upload.currentSize - offset) {
      failLampUpdate("Firmware write failed: " + String(Update.errorString()));
    }
  } else if (upload.status == UPLOAD_FILE_END && otaAccepted) {
    if (!imageValidated || !Update.end(true)) { failLampUpdate("Firmware verification failed. Existing firmware remains selected."); return; }
    otaComplete = true; otaActive = false; otaMessage = "Firmware verified. Restarting…";
  } else if (upload.status == UPLOAD_FILE_ABORTED) {
    failLampUpdate("Upload interrupted. Existing firmware remains selected.");
  }
}

void beginLampNetwork()
{
  beginLampWifiSetupDiagnostics();
  const uint64_t mac = ESP.getEfuseMac();
  char suffix[7]; snprintf(suffix, sizeof(suffix), "%02X%02X%02X", static_cast<uint8_t>(mac >> 24), static_cast<uint8_t>(mac >> 32), static_cast<uint8_t>(mac >> 40));
  lampHost = String("coollamp-") + suffix; lampHost.toLowerCase();
  lampAPName = String("CoolLamp-") + suffix;
  lampName = lampAPName;
  Preferences names;
  if (names.begin("coollamp", true)) { lampName = names.getString("name", lampAPName); names.end(); }
  char token[33]; snprintf(token, sizeof(token), "%08lx%08lx%08lx%08lx", (unsigned long)esp_random(), (unsigned long)esp_random(), (unsigned long)esp_random(), (unsigned long)esp_random());
  lampToken = token;
  const char* headers[] = {"X-Lamp-Token"};
  lampServer.collectHeaders(headers, 1);
  lampServer.on("/", HTTP_GET, []() {
    if (!authorizedLampRequest(false)) return;
    lampServer.sendHeader("X-Content-Type-Options", "nosniff");
    lampServer.sendHeader("X-Frame-Options", "DENY");
    lampServer.send_P(200, "text/html; charset=utf-8", LAMP_PAGE);
  });
  lampServer.on("/api/state", HTTP_GET, sendLampState);
  lampServer.setControlRead(LampControlEndpoint::Sync, [](){
    if(!authorizedLampRequest(false))return;
    lampServer.send(200,"application/json",lampSyncJson());
  });
  lampServer.on("/api/factory-reset",HTTP_POST,[](){
    if(!authorizedLampRequest(true))return;
    if(lampServer.arg("confirm")!="RESET"){lampServer.send(400,"text/plain","Confirm factory reset first.");return;}
    const bool ok=requestLampFactoryReset();
    lampServer.send(ok?200:409,"text/plain",ok?"Factory reset scheduled. Lamp restarting; pair it again afterward.":"Factory reset could not start. Wait for firmware updates to finish and retry.");
  });
  lampServer.on("/api/diagnostics", HTTP_GET, sendLampDiagnostics);
  lampServer.on("/api/sync", HTTP_POST, []() {
    if(!authorizedLampRequest(true))return;
    if(lampUpdateOwnsResources()){lampServer.send(409,"text/plain","Wait for the update to finish.");return;}
    if(lampServer.arg("action")=="pause"){pauseLampSync();lampServer.send(200,"text/plain","Group paused on this lamp.");return;}
    if(lampServer.arg("action")=="resume"){resumeLampSync();lampServer.send(200,"text/plain","Reconnecting to the coordinator.");return;}
    uint32_t role;
    if(!readNumber("role",0,2,role)||!configureLampSync(role,lampServer.arg("leader"),lampServer.arg("key"))){lampServer.send(400,"text/plain","Invalid group code or group settings could not be saved.");return;}
    lampServer.send(200,"text/plain",role?"Group settings saved.":"Left the group. Local settings restored.");
  });
  lampServer.on("/api/sync/scene", HTTP_POST, []() {
    if(!authorizedLampRequest(true))return;
    if(lampUpdateOwnsResources()){lampServer.send(409,"text/plain","Wait for the update to finish.");return;}
    uint32_t scene,speed,intensity,r,g,b,r2,g2,b2;
    if(!readNumber("scene",0,LampSyncWire::SceneCount,scene)||!readNumber("speed",1,100,speed)||!readNumber("intensity",0,100,intensity)||
       !readNumber("r",0,255,r)||!readNumber("g",0,255,g)||!readNumber("b",0,255,b)||
       !readNumber("r2",0,255,r2)||!readNumber("g2",0,255,g2)||!readNumber("b2",0,255,b2)){lampServer.send(400,"text/plain","Invalid scene settings.");return;}
    const uint8_t primary[]={uint8_t(r),uint8_t(g),uint8_t(b)},secondary[]={uint8_t(r2),uint8_t(g2),uint8_t(b2)};
    const bool ok=configureLampScene(scene,speed,intensity,primary,secondary);
    lampServer.send(ok?200:409,"text/plain",ok?"Group scene saved.":"Select the coordinator, check its microphone, and try again.");
  });
  lampServer.on("/api/sync/order", HTTP_POST, []() {
    if(!authorizedLampRequest(true))return;
    if(lampUpdateOwnsResources()){lampServer.send(409,"text/plain","Wait for the update to finish.");return;}
    const bool ok=configureLampOrder(lampServer.arg("order"));
    lampServer.send(ok?200:409,"text/plain",ok?"Lamp order saved.":"Order changed or could not be saved. Refresh and try again.");
  });
  lampServer.on("/api/sync/invite", HTTP_POST, []() {
    if(!authorizedLampRequest(true))return;
    const String invite=lampSyncInvite();
    lampServer.send(invite.length()?200:409,"text/plain",invite.length()?invite:"Create a group on this lamp first.");
  });
  lampServer.on("/api/calibration", HTTP_POST, []() {
    if(!authorizedLampRequest(true))return;
    if(lampUpdateOwnsResources()){lampServer.send(409,"text/plain","Wait for the update to finish.");return;}
    const String action=lampServer.arg("action"),kind=lampServer.arg("kind");bool ok=false;
    const bool center=kind=="center";
    if(!kind.isEmpty()&&kind!="center"&&kind!="leds"){lampServer.send(400,"text/plain","Choose LED setup or center adjustment.");return;}
    if(action=="start")ok=center?beginLampCenterCalibration():beginLampCalibration();
    else if(lampCalibrationActive()&&center==lampCalibrationCenter()) {
      if(action=="move") {uint32_t position;if(readNumber("position",1,lampCalibrationMaximum(),position)){moveLampCalibration(position);ok=true;}}
      else if(action=="save" || action=="cancel")ok=finishLampCalibration(action=="save");
    }
    if(center){lampServer.send(ok?200:409,"text/plain",ok?(action=="save"?"Center saved. Normal lighting restored.":action=="cancel"?"Adjustment canceled. Previous center kept.":"Move the blinking white light with the knob. Click to save; ten seconds without input cancels."):"Could not adjust the center. Finish any other setup or retry saving.");return;}
    lampServer.send(ok?200:409,"text/plain",ok?(action=="save"?"LED count saved. Restarting lamp…":action=="cancel"?"Setup canceled. Previous LED count kept.":"Move the teal light to the last LED. Click the knob to save; double-click to cancel."):"Could not complete setup. Leave any lamp group before starting; retry if saving failed.");
  });
  lampServer.on("/api/rotation", HTTP_POST, []() {
    if(!authorizedLampRequest(true))return;
    if(lampUpdateOwnsResources() || lampCalibrationActive()){lampServer.send(409,"text/plain","Finish setup or updating first.");return;}
    uint32_t enabled,random,category,seconds;
    if(!readNumber("enabled",0,1,enabled)||!readNumber("random",0,1,random)||!readNumber("category",0,2,category)||!readNumber("seconds",5,86400,seconds)){lampServer.send(400,"text/plain","Choose an interval from 5 seconds to 24 hours.");return;}
    LampRotation next;next.enabled=enabled;next.random=random;next.category=category;next.seconds=seconds;
    const bool ok=saveLampRotation(next);
    lampServer.send(ok?200:409,"text/plain",ok?"Effect rotation saved.":"Use an independent lamp or the group controller in Mirror effects. Audio-only needs a microphone.");
  });
  lampServer.on("/api/geometry", HTTP_POST, []() {
    if (!authorizedLampRequest(true)) return;
    if (lampUpdateOwnsResources()) { lampServer.send(409,"text/plain","Wait for the update to finish."); return; }
    uint32_t midpoint;
    if (!readNumber("midpoint",0,NUM_LEDS-1,midpoint)) {
      lampServer.send(400,"text/plain","Center must be 0 (automatic) or a boundary before the last LED."); return;
    }
    if (!saveLampGeometry(midpoint,NUM_LEDS)) { lampServer.send(500,"text/plain","Could not save center point."); return; }
    memset(splitHeat,0,NUM_LEDS);
    splitHeat[0] = 200;
    if (NUM_LEDS > 1) splitHeat[lampSplitCount(NUM_LEDS,lampMidpoint)] = 200;
    lampServer.send(200,"text/plain","Center point saved and applied.");
  });
  lampServer.on("/api/fountain-colors", HTTP_POST, []() {
    if(!authorizedLampRequest(true))return;
    if(lampUpdateOwnsResources() || !lampHasMicrophone()){lampServer.send(409,"text/plain","Enable the microphone and finish updating first.");return;}
    FountainColor colors[3]={{255,65,0},{0,230,130},{75,30,255}};
    if(lampServer.arg("reset")!="1") {
      const char* keys[9]={"r0","g0","b0","r1","g1","b1","r2","g2","b2"};
      uint32_t values[9];
      for(unsigned i=0;i<9;++i)if(!readNumber(keys[i],0,255,values[i])){lampServer.send(400,"text/plain","Invalid Fountain colors.");return;}
      for(unsigned i=0;i<3;++i)colors[i]={uint8_t(values[i*3]),uint8_t(values[i*3+1]),uint8_t(values[i*3+2])};
    }
    if(!saveLampFountainColors(colors)){lampServer.send(500,"text/plain","Could not save Fountain colors.");return;}
    lampServer.send(200,"text/plain","Fountain colors saved and applied.");
  });
  lampServer.on("/api/vu-colors", HTTP_POST, []() {
    if(!authorizedLampRequest(true))return;
    if(lampUpdateOwnsResources() || !lampHasMicrophone()){lampServer.send(409,"text/plain","Enable the microphone and finish updating first.");return;}
    VuColor colors[3]={{0,255,0},{255,255,0},{255,0,0}};
    if(lampServer.arg("reset")!="1") {
      const char* keys[9]={"r0","g0","b0","r1","g1","b1","r2","g2","b2"};
      uint32_t values[9];
      for(unsigned i=0;i<9;++i)if(!readNumber(keys[i],0,255,values[i])){lampServer.send(400,"text/plain","Invalid VU colors.");return;}
      for(unsigned i=0;i<3;++i)colors[i]={uint8_t(values[i*3]),uint8_t(values[i*3+1]),uint8_t(values[i*3+2])};
    }
    if(!saveLampVuColors(colors)){lampServer.send(500,"text/plain","Could not save VU colors.");return;}
    lampServer.send(200,"text/plain","VU colors saved and applied.");
  });
  lampServer.on("/api/audio", HTTP_GET, []() {
    if (!authorizedLampRequest(false)) return;
    lampServer.send(200, "application/json", lampAudioJson());
  });
  lampServer.on("/api/audio", HTTP_POST, []() {
    if (!authorizedLampRequest(true)) return;
    if (lampUpdateOwnsResources()) { lampServer.send(409,"text/plain","Wait for the update to finish."); return; }
    uint32_t enabled, gain, gate, scale = lampAudioScale();
    if (!readNumber("enabled",0,1,enabled) || !readNumber("gain",1,64,gain) || !readNumber("gate",0,1024,gate) || (lampServer.hasArg("scale") && !readNumber("scale",100,400,scale))) {
      lampServer.send(400,"text/plain","Invalid microphone settings."); return;
    }
    if (!saveLampAudioConfiguration(enabled,gain,gate,scale)) { lampServer.send(500,"text/plain","Could not save microphone settings."); return; }
    lampServer.send(200,"text/plain","Microphone settings saved. Restarting; reconnect to refresh effects.");
    restartAt = millis() + 1000;
  });
  lampServer.on("/api/audio/tuning", HTTP_POST, []() {
    if (!authorizedLampRequest(true)) return;
    if (!lampHasMicrophone() || lampUpdateOwnsResources()) { lampServer.send(409,"text/plain","Enable the microphone and finish updating first."); return; }
    uint32_t gain,gate,scale;
    if (!readNumber("gain",1,64,gain) || !readNumber("gate",0,1024,gate) || !readNumber("scale",100,400,scale)) {
      lampServer.send(400,"text/plain","Invalid audio tuning values."); return;
    }
    if (!tuneLampAudio(gain,gate,scale)) { lampServer.send(500,"text/plain","Could not apply audio tuning. Try again."); return; }
    lampServer.send(200,"text/plain","Audio tuning saved for all audio effects.");
  });
  lampServer.on("/api/audio/test", HTTP_POST, []() {
    if (!authorizedLampRequest(true)) return;
    if (!lampHasMicrophone() || lampUpdateOwnsResources()) {
      lampServer.send(409,"text/plain","Enable the installed microphone and finish updating first."); return;
    }
    diagnoseLampAudio(); lampServer.send(200,"text/plain","Listening for 10 seconds.");
  });
  lampServer.on("/api/style", HTTP_POST, []() {
    if (!authorizedLampRequest(true)) return;
    if (lampUpdateOwnsResources() || otaActive || lampCalibrationActive() || lampWifiSetupBusy() || lampFactoryResetPending()) {
      lampServer.send(409,"text/plain","Finish setup or updating before changing lamp design."); return;
    }
    uint32_t style;
    if (!readNumber("style",0,3,style)) {
      lampServer.send(400,"text/plain","Choose a supported lamp design."); return;
    }
    if (!configureLampStyle(static_cast<uint8_t>(style))) {
      lampServer.send(500,"text/plain","Could not save lamp design."); return;
    }
    lampServer.send(200,"application/json",lampStyleJson());
  });
  lampServer.on("/api/name", HTTP_POST, []() {
    if (!authorizedLampRequest(true)) return;
    if (lampIsUpdating()) { lampServer.send(409,"text/plain","Wait for the update to finish."); return; }
    String name = lampServer.arg("name"); name.trim();
    bool valid = !name.isEmpty() && name.length() <= 48;
    for (size_t i=0;i<name.length();++i) if (static_cast<uint8_t>(name[i])<32) valid=false;
    if (!valid) { lampServer.send(400,"text/plain","Use a name of 1 to 48 UTF-8 bytes."); return; }
    Preferences prefs;
    bool saved = prefs.begin("coollamp",false);
    if (saved) { saved=prefs.putString("name",name)>0; prefs.end(); }
    if (!saved) { lampServer.send(500,"text/plain","Could not save lamp name."); return; }
    lampName=name;
    if (mdnsStarted) MDNS.addServiceTxt("coollamp","tcp","name",lampName);
    lampServer.send(200,"text/plain","Lamp name saved.");
  });
  lampServer.on("/api/identify", HTTP_POST, []() {
    if (!authorizedLampRequest(true)) return;
    if (lampIsUpdating() || lampPairingOpen() || lampSetupPulse()) { lampServer.send(409,"text/plain","Finish setup or updating before identifying the lamp."); return; }
    identifyUntil=millis()+2400;
    lampServer.send(200,"text/plain","Lamp is flashing white.");
  });
  lampServer.on("/api/scan", HTTP_POST, startLampScan);
  lampServer.on("/api/scan", HTTP_GET, []() {
    if (!authorizedLampRequest(false)) return;
    ++scanPolls;
    lampServer.send(200, "application/json", scanResults);
  });
  lampServer.on("/api/config", HTTP_POST, saveLampConfiguration);
  lampServer.on("/api/effects", HTTP_GET, []() {
    if (!authorizedLampRequest(false)) return;
    String catalog = "[";
    for (uint8_t mode=1; mode<=lampAvailableEffectCount(); ++mode) { if (mode>1) catalog+=','; catalog+=lampEffectCatalogEntry(mode); }
    catalog+=']';
    lampServer.send(200, "application/json", catalog);
  });
  lampServer.on("/api/firmware", HTTP_GET, []() {
    if (!authorizedLampRequest(false)) return;
    lampServer.send(200, "application/json", lampUpdateJson());
  });
  lampServer.on("/api/firmware/check", HTTP_POST, []() {
    if (!authorizedLampRequest(true)) return;
    const bool ok = requestLampUpdateCheck();
    lampServer.send(ok ? 202 : 409, "text/plain", ok ? "Checking for firmware updates…" : "Updater busy or starting. Try again shortly.");
  });
  lampServer.on("/api/firmware/install", HTTP_POST, []() {
    if (!authorizedLampRequest(true)) return;
    const bool ok = requestLampUpdateInstall();
    lampServer.send(ok ? 202 : 409, "text/plain", ok ? "Installing update. The lamp will restart when verified." : "No update available, or updater busy. Check again shortly.");
  });
  lampServer.on("/api/firmware/automatic", HTTP_POST, []() {
    if (!authorizedLampRequest(true)) return;
    uint32_t enabled;
    if (!readNumber("enabled", 0, 1, enabled)) { lampServer.send(400, "text/plain", "Invalid setting."); return; }
    const bool ok = !otaActive && setLampAutoUpdate(enabled);
    lampServer.send(ok ? 200 : 409, "text/plain", ok ? "Automatic update setting saved." : "Could not save while updater is busy. Try again shortly.");
  });
  lampServer.on("/api/effect-options", HTTP_POST, []() {
    if (!authorizedLampRequest(true)) return;
    if (lampIsUpdating()) { lampServer.send(409,"text/plain","Wait for the update to finish."); return; }
    uint32_t mode,speed,intensity,dual,r,g,b;
    if (!readNumber("mode",1,lampAvailableEffectCount(),mode)||!readNumber("speed",1,100,speed)||!readNumber("intensity",0,100,intensity)||!readNumber("dual",0,1,dual)||!readNumber("r",0,255,r)||!readNumber("g",0,255,g)||!readNumber("b",0,255,b)) { lampServer.send(400,"text/plain","Invalid effect options."); return; }
    setLampEffectOptions(mode,{uint8_t(speed),uint8_t(intensity),uint8_t(dual),uint8_t(r),uint8_t(g),uint8_t(b)});
    lampServer.send(200,"text/plain","Effect options applied. Save settings to remember them.");
  });
  lampServer.on("/api/color", HTTP_POST, []() {
    if (!authorizedLampRequest(true)) return;
    if (otaActive || lampRemoteUpdateBusy()) { lampServer.send(409, "text/plain", "Wait for the firmware upload to finish."); return; }
    uint32_t mode, r, g, b;
    if (!readNumber("mode", 1, lampAvailableEffectCount(), mode)) { lampServer.send(400, "text/plain", "Invalid effect."); return; }
    if (lampServer.arg("reset") == "1") resetLampColor(mode);
    else {
      if (!readNumber("r", 0, 255, r) || !readNumber("g", 0, 255, g) || !readNumber("b", 0, 255, b)) {
        lampServer.send(400, "text/plain", "Invalid RGB color."); return;
      }
      setLampColor(mode, r, g, b);
    }
    setLampControl(mode, Brightness, PowerOn);
    lampServer.send(200, "text/plain", "Color applied. Save settings to keep it after restart.");
  });
  lampServer.on("/api/bluetooth", HTTP_GET, []() {
    if (!authorizedLampRequest(false)) return;
    lampServer.send(200, "application/json", lampBluetoothStatusJson());
  });
  lampServer.on("/api/bluetooth/forget", HTTP_POST, []() {
    if (!authorizedLampRequest(true)) return;
    if (!lampPairingOpen() || otaActive) { lampServer.send(409, "text/plain", "Hold the knob for six seconds to open pairing first; wait for any update to finish."); return; }
    forgetLampPhones();
    lampServer.send(200, "text/plain", "Saved phones removed. Forget CoolLamp in your phone's Bluetooth settings before pairing again.");
  });
  lampServer.on("/api/defaults", HTTP_POST, []() {
    if (!authorizedLampRequest(true)) return;
    if (otaActive || lampRemoteUpdateBusy()) { lampServer.send(409, "text/plain", "Wait for the firmware upload to finish."); return; }
    const bool saved = saveLampDefaults();
    lampServer.send(saved ? 200 : 500, "text/plain", saved ? "Startup effect and brightness saved." : "Could not save defaults.");
  });
  lampServer.on("/api/preview", HTTP_POST, []() {
    if (!authorizedLampRequest(true)) return;
    if (otaActive || lampRemoteUpdateBusy()) { lampServer.send(409, "text/plain", "Wait for the firmware upload to finish."); return; }
    uint32_t mode, brightness;
    if (!readNumber("mode", 1, lampAvailableEffectCount(), mode) || !readNumber("brightness", 1, 255, brightness)) { lampServer.send(400, "text/plain", "Invalid effect or brightness."); return; }
    setLampControl(mode, brightness, lampServer.arg("keepPower") == "1" ? PowerOn : true);
    lampServer.send(200, "text/plain", "Preview applied. Save settings to keep it after restart.");
  });
  lampServer.on("/api/power", HTTP_POST, []() {
    if (!authorizedLampRequest(true)) return;
    if (otaActive || lampRemoteUpdateBusy()) { lampServer.send(409, "text/plain", "Wait for the firmware upload to finish."); return; }
    uint32_t on;
    if (!readNumber("on", 0, 1, on)) { lampServer.send(400, "text/plain", "Invalid power value."); return; }
    setLampControl(Mode, Brightness, on); FastLED.show();
    lampServer.send(200, "text/plain", PowerOn ? "Light on." : "Light off.");
  });
  lampServer.on("/api/mesh/status", HTTP_GET, [](){
    if(!authorizedLampRequest(false))return;lampServer.send(200,"application/json",LampMeshAdapter::statusJson());
  });
  lampServer.on("/api/mesh/request", HTTP_POST, [](){
    if(!authorizedLampRequest(true))return;
    const auto reply=LampMeshAdapter::request(lampServer.arg("target"),lampServer.arg("requestId"),lampServer.arg("endpoint"),lampServer.arg("method"),lampServer.arg("body"));lampServer.send(reply.status,"application/json",reply.body);
  });
  // This POST only reads a retained result; it never dispatches the command.
  lampServer.on("/api/mesh/result", HTTP_POST, [](){
    if(!authorizedLampRequest(true))return;
    const auto reply=LampMeshAdapter::result(lampServer.arg("target"),lampServer.arg("requestId"),lampServer.arg("offset"));lampServer.send(reply.status,"application/json",reply.body);
  });
  lampServer.on("/api/mesh/new", HTTP_GET, [](){
    if(!authorizedLampRequest(false))return;lampServer.send(200,"application/json",LampCommission::candidatesJson());
  });
  lampServer.on("/api/mesh/enroll/start", HTTP_POST, [](){
    if(!authorizedLampRequest(true))return;const auto reply=LampCommission::start(lampServer.arg("target"),lampServer.arg("requestId"),lampServer.arg("broker"));lampServer.send(reply.status,"application/json",reply.body);
  });
  lampServer.on("/api/mesh/enroll/status", HTTP_POST, [](){
    if(!authorizedLampRequest(true))return;const auto reply=LampCommission::status(lampServer.arg("target"),lampServer.arg("requestId"),lampServer.arg("broker"));lampServer.send(reply.status,"application/json",reply.body);
  });
  lampServer.on("/api/mesh/enroll/cancel", HTTP_POST, [](){
    if(!authorizedLampRequest(true))return;const auto reply=LampCommission::cancel(lampServer.arg("target"),lampServer.arg("requestId"),lampServer.arg("broker"));lampServer.send(reply.status,"application/json",reply.body);
  });
  lampServer.on("/update", HTTP_POST, []() {
    if (!authorizedLampRequest(true)) return;
    lampServer.send(otaComplete ? 200 : 400, "text/plain", otaMessage);
    if (otaComplete) restartAt = millis() + 1200;
  }, receiveLampUpdate);
  lampServer.onNotFound([]() { lampServer.send(404, "text/plain", "Not found."); });
  WiFi.persistent(false);
  // The lamp is mains-powered; keep reception responsive for phone controls
  // and group discovery rather than waiting for the router's DTIM interval.
  WiFi.setSleep(false);
  WiFi.setHostname(lampHost.c_str());
  if (lampSettings.ssid[0]) {
    WiFi.mode(WIFI_STA); WiFi.setAutoReconnect(true);
    applyLampWifiPowerProfile();
    WiFi.begin(lampSettings.ssid, lampSettings.wifiPassword);
  } else { WiFi.mode(WIFI_STA); applyLampWifiPowerProfile(); }
  beginLampBluetooth(lampAPName);
}

void toggleLampSetup()
{
  if (setupAP) {
    WiFi.softAPdisconnect(true); setupAP = false;
    WiFi.mode(WIFI_STA);
  } else {
    // Scanning needs STA even before home Wi-Fi credentials have been saved.
    // Enable it before clients join, rather than changing mode mid-request.
    WiFi.mode(WIFI_AP_STA);
    setupAP = WiFi.softAP(lampAPName.c_str(), lampSettings.adminPassword);
    lastAPStartOK = setupAP;
    apLastActivity = millis();
  }
  setupPulseStart = millis(); setupPulseActive = setupAP;
}

void cancelLampSetupPulse() { setupPulseActive = false; }

bool lampSetupPulse()
{
  if (setupPulseActive && millis() - setupPulseStart >= 3000) setupPulseActive = false;
  return setupPulseActive;
}

bool lampIsUpdating() {
  const auto state = getLampUpdateStatus();
  return otaActive || state.phase == UPDATE_DOWNLOADING || state.phase == UPDATE_RESTARTING;
}

// USB-only recovery/diagnostics. No credentials are included in replies.
void serviceLampUSB()
{
  static bool statusPending = false;
  static bool audioPending = false;
  static bool scanPending = false;
  static bool wifiSetupPending = false;
  static bool centerPending = false;
  static bool bluetoothPending = false;
  static bool diagnosticsPending = false;
  static String audioReply;
  static size_t audioSent = 0;
  while (Serial.available()) {
    const char command = Serial.read();
    if (command == '?') statusPending = true;
    if (command == 'w') scanPending = true;
    if (command == 'b') {
      const uint8_t scan[4] = {1, 1, WifiSetupWire::CONTROL, 1}; String response;
      lampWifiSetupCommand(scan, sizeof(scan), 0, response); wifiSetupPending = true;
    }
    if (command == 'p') wifiSetupPending = true;
    if (command == 'q') bluetoothPending = true;
    if (command == 'd') diagnosticsPending = true;
    if (command == 'c') { beginLampCenterCalibration(); centerPending = true; }
    if (command == 'j') centerPending = true;
    if (command == 's' && setupAP && !otaActive && !lampRemoteUpdateBusy()) {
      beginLampScan(); scanPending = true;
    }
    if (command == 'a' && !otaActive) { toggleLampSetup(); statusPending = true; }
    if (command == 't' && !lampUpdateOwnsResources()) { diagnoseLampAudio(); audioPending = true; }
    if (command == 'u') audioPending = true;
    if (!lampUpdateOwnsResources()) {
      if (command == '+' || command == '-') { adjustLampAudioGain(command == '+'); audioPending = true; }
      if (command >= '1' && command <= '5') setLampControl(MODE_SPECTRUM_RISE + command - '1', Brightness, true);
      if (command == '6') setLampControl(MODE_VU_METER, Brightness, true);
      if (command == 'g') setLampControl(MODE_SOUND_GLOW, Brightness, true);
      if (command == 'v') setLampControl(MODE_SOUND_METER, Brightness, true);
      if (command == 'f') setLampControl(MODE_FIRE, Brightness, PowerOn);
    }
    // USB factory provisioning, persistent across ordinary OTA. Never erase NVS.
    if ((command == 'm' || command == 'n') && !lampUpdateOwnsResources()) {
      if (saveLampAudioConfiguration(command == 'm', 8, 8)) restartAt = millis() + 1000;
    }
  }
  if (wifiSetupPending && audioReply.isEmpty()) { audioReply = lampWifiSetupJson() + "\n"; audioSent = 0; wifiSetupPending = false; }
  if (bluetoothPending && audioReply.isEmpty()) { audioReply = lampBluetoothStatusJson() + "\n"; audioSent = 0; bluetoothPending = false; }
  if (diagnosticsPending && audioReply.isEmpty()) { audioReply = lampDiagnosticsJson() + "\n"; audioSent = 0; diagnosticsPending = false; }
  if (centerPending && audioReply.isEmpty()) { audioReply = lampCenterCalibrationJson() + "\n"; audioSent = 0; centerPending = false; }
  if (audioPending && audioReply.isEmpty()) { audioReply = lampAudioJson() + "\n"; audioSent = 0; audioPending = false; }
  if (!audioReply.isEmpty()) {
    const size_t room = Serial.availableForWrite();
    const size_t count = min(room, audioReply.length() - audioSent);
    if (count) audioSent += Serial.write(reinterpret_cast<const uint8_t*>(audioReply.c_str()) + audioSent, count);
    if (audioSent == audioReply.length()) audioReply = "";
  }
  if (statusPending) {
    String status = "reset=" + String(static_cast<int>(esp_reset_reason())) + " uptime=" + String(millis());
    status += " ap=" + String(setupAP) + " apOK=" + String(lastAPStartOK) + " mode=" + String(static_cast<int>(WiFi.getMode()));
    status += " ssid=" + lampAPName + " ip=" + WiFi.softAPIP().toString() + " heap=" + String(ESP.getFreeHeap()) + "\n";
    if (Serial.availableForWrite() >= static_cast<int>(status.length())) {
      Serial.write(reinterpret_cast<const uint8_t*>(status.c_str()), status.length());
      statusPending = false;
    }
  }
  if (scanPending) {
    // No SSIDs, passwords, or tokens in USB scan diagnostics.
    String report = "scan=" + String(scanCount) + " active=" + String(scanActive);
    report += " ms=" + String(scanActive ? millis() - scanStartedAt : scanDuration);
    report += " polls=" + String(scanPolls) + " clients=" + String(WiFi.softAPgetStationNum()) + "\n";
    if (Serial.availableForWrite() >= static_cast<int>(report.length())) {
      Serial.print(report); scanPending = false;
    }
  }
}

bool serviceLampOfflineWifi(uint32_t now) {
  static LampWifiRecoveryPolicy policy;
  wifi_ap_record_t accessPoint{};
  const bool associated=WiFi.status()==WL_CONNECTED || esp_wifi_sta_get_ap_info(&accessPoint)==ESP_OK;
  const bool groupIntent=lampSyncRole()>0 && !(lampSyncRole()==2&&lampSyncPaused());
  const bool intent=lampSettings.ssid[0] && (groupIntent||LampMeshAdapter::enabled());
  const bool busy=setupAP || scanActive || LampCommission::working() || lampWifiSetupBusy() || lampUpdateOwnsResources() || lampFactoryResetPending() || lampPairingOpen();
  const auto action=policy.tick(now,intent,associated,busy,WiFi.getAutoReconnect());
  if(action==LampWifiRecoveryPolicy::Suspend){WiFi.setAutoReconnect(false);WiFi.disconnect(false,false);}
  else if(action==LampWifiRecoveryPolicy::Restore){
    WiFi.setAutoReconnect(true);
    // The core setter only changes a flag. A deliberate offline disconnect
    // needs an explicit retry when grouping ends, without disturbing DHCP.
    if(!associated&&lampSettings.ssid[0])WiFi.reconnect();
  }
  else if(action==LampWifiRecoveryPolicy::Probe){if(!WiFi.reconnect())policy.failed(now);}
  else if(action==LampWifiRecoveryPolicy::AbortProbe)WiFi.disconnect(false,false);
  return policy.probing()&&!associated;
}

// Freeze only unassociated Wi-Fi retries during a Bluetooth image transfer.
// These are transient core flags; saved credentials and Wi-Fi mode stay intact.
bool bluetoothUpdateWifiHeld=false,bluetoothUpdateWifiAutomatic=false;
bool beginLampBluetoothUpdateRadio() {
  if(scanActive)return false;
  if(bluetoothUpdateWifiHeld)return true;
  wifi_ap_record_t accessPoint{};
  if(WiFi.status()==WL_CONNECTED||esp_wifi_sta_get_ap_info(&accessPoint)==ESP_OK)return true;
  bluetoothUpdateWifiHeld=true;bluetoothUpdateWifiAutomatic=WiFi.getAutoReconnect();
  WiFi.setAutoReconnect(false);WiFi.disconnect(false,false);
  return true;
}
void finishLampBluetoothUpdateRadio(bool restarting) {
  if(!bluetoothUpdateWifiHeld||restarting)return;
  bluetoothUpdateWifiHeld=false;WiFi.setAutoReconnect(bluetoothUpdateWifiAutomatic);
  if(bluetoothUpdateWifiAutomatic&&lampSettings.ssid[0])WiFi.reconnect();
}

void serviceLampNetwork()
{
  serviceLampUSB();
  serviceLampScan();
  serviceLampWifiSetup();
  const uint32_t now = millis();
  if (restartAt && static_cast<int32_t>(now - restartAt) >= 0) ESP.restart();
  if (otaActive && now - otaLastActivity > 30000) failLampUpdate("Upload timed out.");
  // A BLE join keeps credentials provisional until DHCP succeeds. Expiring the
  // hotspot during that attempt would otherwise switch a new lamp's radio OFF.
  if (setupAP && !otaActive && !lampUpdateOwnsResources() && !lampWifiSetupBusy() && !scanActive && now - apLastActivity > 600000) {
    WiFi.softAPdisconnect(true); setupAP = false;
    WiFi.mode(WIFI_STA);
  }
  const bool connected = WiFi.status() == WL_CONNECTED;
  // Keep DHCP's primary resolver. Supply a backup when the router provides none.
  if (connected && WiFi.dnsIP(1) == IPAddress(0, 0, 0, 0)) {
    WiFi.STA.dnsIP(1, IPAddress(1, 1, 1, 1));
  }
  if ((setupAP || connected) && !serverStarted) { lampServer.begin(); serverStarted = true; }
  if (!setupAP && !connected && serverStarted) { lampServer.stop(); serverStarted = false; }
  if (connected && !mdnsStarted) {
    mdnsStarted = MDNS.begin(lampHost.c_str());
    if (mdnsStarted) {
      MDNS.addService("http", "tcp", 80);
      MDNS.addService("coollamp", "tcp", 80);
      MDNS.addServiceTxt("coollamp", "tcp", "id", lampIdentity());
      MDNS.addServiceTxt("coollamp", "tcp", "name", lampName);
      MDNS.addServiceTxt("coollamp", "tcp", "api", "2");
    }
  }
  if (!connected && mdnsStarted) { MDNS.end(); mdnsStarted = false; }
  if (serverStarted) lampServer.handleClient();
  const bool probeScanning=serviceLampOfflineWifi(now);
  serviceLampSync(lampName, (lampUpdateOwnsResources()&&!LampFirmwareRelay::ownsRadio()) || setupAP || lampPairingOpen() || lampWifiSetupBusy() || lampFactoryResetPending(),scanActive||probeScanning);
}

bool saveLampDefaults()
{
  if(lampSyncFollowing()) return false;
  LampSettings next = lampSettings;
  next.brightness = Brightness;
  next.startupMode = Mode;
  if (next.brightness == lampSettings.brightness && next.startupMode == lampSettings.startupMode) return saveLampColors();
  Preferences prefs;
  if (!prefs.begin("coollamp", false)) return false;
  const bool saved = prefs.putBytes("settings", &next, sizeof(next)) == sizeof(next);
  prefs.end();
  if (saved) lampSettings = next;
  return saved && saveLampColors();
}

bool saveLampKnobBrightness()
{
  if(lampSyncFollowing()) return false;
  // Knob brightness edits must not replace the chosen startup effect or Wi-Fi.
  if (lampSettings.brightness == Brightness) return true;
  LampSettings next = lampSettings;
  next.brightness = Brightness;
  Preferences prefs;
  if (!prefs.begin("coollamp", false)) return false;
  const bool saved = prefs.putBytes("settings", &next, sizeof(next)) == sizeof(next);
  prefs.end();
  if (saved) lampSettings = next;
  return saved;
}

// Keep network credentials, startup settings, and power limits unchanged.
bool saveLampLedCount(uint16_t count) {
  if(!count || count>MAX_LED_COUNT)return false;
  LampSettings next=lampSettings;next.ledCount=count;
  Preferences prefs;if(!prefs.begin("coollamp",false))return false;
  const bool ok=prefs.putBytes("settings",&next,sizeof(next))==sizeof(next);prefs.end();
  if(ok){lampSettings=next;restartAt=millis()+1200;}return ok;
}

String lampCenterCalibrationJson(){
  return String("{\"version\":1,\"active\":")+(lampCalibrationCenter()?"true":"false")+
    ",\"position\":"+String(lampCalibrationCenter()?lampCalibrationPosition():lampSplitCount(NUM_LEDS,lampMidpoint))+
    ",\"midpoint\":"+String(lampMidpoint)+",\"leds\":"+String(NUM_LEDS)+"}";
}
