jammendolia/CoolLamp/LampBluetooth.cpp

#include "LampBluetooth.h"
#include "LampControl.h"
#include "LampConfig.h"
#include "LampUpdate.h"
#include "LampWifiSetup.h"
#include "LampFactoryReset.h"
#include "LampPlayback.h"
#include "LampBleControl.h"
#include "LampBleUpdate.h"

#if COOL_LAMP_BLE
#include <BLEDevice.h>
#include <BLEServer.h>
#include <BLESecurity.h>
#include <host/ble_store.h>
#include <services/gatt/ble_svc_gatt.h>
#if !defined(CONFIG_NIMBLE_ENABLED)
#error CoolLamp Bluetooth requires the NimBLE backend shipped with ESP32-C3 Arduino core 3.3.11.
#endif
#include <atomic>
#include <freertos/FreeRTOS.h>
#include <freertos/queue.h>

namespace {
constexpr char SERVICE[] = "7b610001-6e2b-4f3d-9a71-28e45c001001";
constexpr char COMMAND[] = "7b610002-6e2b-4f3d-9a71-28e45c001001";
constexpr char STATE[]   = "7b610003-6e2b-4f3d-9a71-28e45c001001";
constexpr char FIRMWARE[] = "7b610004-6e2b-4f3d-9a71-28e45c001001";
constexpr char EFFECT[] = "7b610005-6e2b-4f3d-9a71-28e45c001001";
constexpr char IDENTITY[] = "7b610006-6e2b-4f3d-9a71-28e45c001001";
constexpr char WIFI_SETUP[] = "7b610008-6e2b-4f3d-9a71-28e45c001001";
constexpr char CONTROL_RPC[] = "7b61000a-6e2b-4f3d-9a71-28e45c001001";
constexpr char OTA_WRITE[] = "7b61000b-6e2b-4f3d-9a71-28e45c001001";
constexpr char OTA_STATUS[] = "7b61000c-6e2b-4f3d-9a71-28e45c001001";
BLECharacteristic* otaStatusCharacteristic=nullptr;
uint8_t lastOtaStatus[20]{};
BLECharacteristic* wifiCharacteristic = nullptr;
BLECharacteristic* centerCharacteristic = nullptr;
BLECharacteristic* controlCharacteristic = nullptr;
LampBleControlWire::FrameQueue controlCommands;
std::atomic<uint32_t> controlPageGeneration{0};
std::atomic<uint16_t> controlPageTransaction{0};
std::atomic<bool> controlPageReady{false};
// Catalog negotiated per connection: 0 = baseline, 37 = legacy app, 38 = outward droplets.
std::atomic<uint8_t> extendedControls{0};
BLECharacteristic* catalogCharacteristic = nullptr;
BLECharacteristic* effectCharacteristic = nullptr;
uint8_t lastEffect[8] = {};
constexpr uint16_t NO_CONNECTION = 0xffff;
struct Command { uint32_t generation; uint8_t length; uint8_t bytes[20]; };
QueueHandle_t commands = nullptr;
BLEServer* server = nullptr;
BLECharacteristic* stateCharacteristic = nullptr;
BLECharacteristic* firmwareCharacteristic = nullptr;
uint8_t lastFirmware[20] = {};
std::atomic<uint16_t> connection{NO_CONNECTION};
std::atomic<uint32_t> generation{0};
std::atomic<bool> secure{false}, knownPeer{false}, pairing{false};
std::atomic<bool> disconnectRequested{false};
uint32_t pairingStarted = 0;
String bluetoothName;
std::atomic<bool> advertisingDirty{false};
// Retain transport milestones after disconnect. No addresses or command payloads.
std::atomic<uint32_t> connects{0}, authentications{0}, writes{0}, acknowledgments{0}, rejectedWrites{0};
std::atomic<uint8_t> lastOperation{0}, lastCommandId{0}, lastAckId{0};
std::atomic<int> lastNotifyStatus{-1}, lastNotifyCode{0};
std::atomic<bool> lastEncrypted{false}, lastBonded{false};
std::atomic<uint32_t> stateReads{0};
std::atomic<uint16_t> lastReadLength{0};
std::atomic<uint32_t> serviceRefreshes{0};
ble_addr_t refreshedPeers[CONFIG_BT_NIMBLE_MAX_BONDS]{};
uint8_t refreshedPeerCount=0;
std::atomic<bool> lastAuthAccepted{false}, rejectedSecure{false}, rejectedSameConnection{false}, rejectedEncrypted{false};
std::atomic<uint32_t> lastAuthAt{0},lastWriteAt{0},lastDisconnectAt{0};
uint32_t revision = 0;
uint8_t lastState[16] = {};

int bondedPeers(ble_addr_t* peers)
{
  int count = 0;
  if (ble_store_util_bonded_peers(peers, &count, CONFIG_BT_NIMBLE_MAX_BONDS) != 0) return 0;
  return count;
}

bool bonded(const ble_addr_t& address)
{
  ble_addr_t peers[CONFIG_BT_NIMBLE_MAX_BONDS];
  const int count = bondedPeers(peers);
  for (int i = 0; i < count; ++i) if (ble_addr_cmp(&peers[i], &address) == 0) return true;
  return false;
}

bool authorizeEncryptedPeer(const ble_gap_conn_desc& peer)
{
  // Bonded reconnections can serve encrypted ATT requests without delivering
  // the wrapper's authentication-complete callback. Use the live descriptor;
  // encryption alone never admits a phone outside the owner/enrollment policy.
  if(disconnectRequested || connection!=peer.conn_handle || !peer.sec_state.encrypted || !(knownPeer || pairing || secure))return false;
  secure=true;
  if(peer.sec_state.bonded)knownPeer=true;
  return true;
}

class Connections final : public BLEServerCallbacks {
  void onConnect(BLEServer* s, ble_gap_conn_desc* event) override {
    uint16_t empty = NO_CONNECTION;
    if (!connection.compare_exchange_strong(empty, event->conn_handle)) {
      s->disconnect(event->conn_handle);
      return;
    }
    secure = false;
    disconnectRequested=false;
    ++connects;
    knownPeer = bonded(event->peer_id_addr);
    ++generation;
    extendedControls = false;
    if (!knownPeer && !pairing) { disconnectRequested=true;s->disconnect(event->conn_handle); }
    // Reading the protected state characteristic starts OS-managed pairing.
  }
  void onDisconnect(BLEServer*, ble_gap_conn_desc* event) override {
    if (connection != event->conn_handle) return;
    disconnectRequested=true;
    lastDisconnectAt=millis();
    secure = false;
    knownPeer = false;
    ++generation;
    extendedControls = false;
    connection = NO_CONNECTION;
    disconnectRequested=false;
    advertisingDirty = true;
  }
};

class Security final : public BLESecurityCallbacks {
  bool onSecurityRequest() override { return knownPeer || pairing; }
  uint32_t onPassKeyRequest() override { return 0; }
  void onPassKeyNotify(uint32_t) override {}
  bool onConfirmPIN(uint32_t) override { return false; }
  void onAuthenticationComplete(ble_gap_conn_desc* result) override {
    if (connection != result->conn_handle) return;
    ++authentications;
    lastEncrypted = result->sec_state.encrypted;
    lastBonded = result->sec_state.bonded;
    secure = authorizeEncryptedPeer(*result);
    lastAuthAccepted=secure.load();lastAuthAt=millis();
    if (!secure && connection != NO_CONNECTION) {
      disconnectRequested=true;
      if (!knownPeer) ble_store_util_delete_peer(&result->peer_id_addr);
      server->disconnect(connection);
    }
  }
};

class StateReads final : public BLECharacteristicCallbacks {
  void onStatus(BLECharacteristic*, Status status, uint32_t code) override {
    lastNotifyStatus = static_cast<int>(status); lastNotifyCode = code;
  }
  void onRead(BLECharacteristic* characteristic, ble_gap_conn_desc* peer) override {
    if(peer)authorizeEncryptedPeer(*peer);
    ++stateReads; lastReadLength = characteristic->getLength();
    // A newly connected older app may read before the loop has refreshed the
    // previous client's extended catalog. Always provide its initial baseline.
    if (extendedControls) return;
    const String cached = characteristic->getValue();
    if (cached.length() != 16) return;
    uint8_t value[16]; memcpy(value, cached.c_str(), sizeof(value));
    if (value[3] > 29) value[3] = 29;
    value[6] = 29;
    characteristic->setValue(value, sizeof(value));
  }
};

class Writes final : public BLECharacteristicCallbacks {
  void onWrite(BLECharacteristic* characteristic, ble_gap_conn_desc* event) override {
    ++writes;
    lastWriteAt=millis();
    if (!authorizeEncryptedPeer(*event)) {
      rejectedSecure=secure.load();rejectedSameConnection=connection==event->conn_handle;rejectedEncrypted=event->sec_state.encrypted;
      ++rejectedWrites; return;
    }
    String value = characteristic->getValue();
    if (value.length() >= 3) { lastCommandId = uint8_t(value[1]); lastOperation = uint8_t(value[2]); }
    // Protocol frames fit the minimum BLE MTU. No long/prepared writes.
    const size_t expected = value.length() >= 3 ? (uint8_t(value[2]) == 6 ? 7 : uint8_t(value[2]) == 11 ? 10 : uint8_t(value[2])==21?5:4) : 4;
    const bool wifiFrame = value.length() >= 3 && uint8_t(value[2]) >= WifiSetupWire::CONTROL && uint8_t(value[2]) <= WifiSetupWire::COMMIT;
    const bool controlFrame=value.length()>=3&&LampBleControlWire::operation(uint8_t(value[2]));
    const auto eraseControlWrite=[&](){
      if(!controlFrame)return;
      const size_t length=value.length();
      LampBleControlWire::zero(const_cast<char*>(value.c_str()),length);
      uint8_t erased[20]{};characteristic->setValue(erased,length>sizeof(erased)?sizeof(erased):length);
    };
    // Offline configuration/private invitations require a completed bond, not
    // merely encryption while a new phone is still enrolling.
    if(controlFrame&&!event->sec_state.bonded){eraseControlWrite();++rejectedWrites;return;}
    if (controlFrame ? !LampBleControlWire::validFrame(reinterpret_cast<const uint8_t*>(value.c_str()),value.length()) : wifiFrame ? !WifiSetupWire::validFrame(reinterpret_cast<const uint8_t*>(value.c_str()), value.length()) : value.length() != expected) {
      eraseControlWrite();
      disconnectRequested=true;
      server->disconnect(event->conn_handle);
      return;
    }
    if(controlFrame){
      LampBleControlWire::Frame command{};
      command.generation=generation;command.length=value.length();
      memcpy(command.bytes,value.c_str(),command.length);
      if(!controlCommands.push(command)){disconnectRequested=true;server->disconnect(event->conn_handle);}
      LampBleControlWire::zero(&command,sizeof(command));
      eraseControlWrite();
      return;
    }
    Command command{};
    command.generation = generation;
    command.length = value.length();
    memcpy(command.bytes, value.c_str(), command.length);
    // Never change FastLED, Preferences, or Wi-Fi state on the Bluetooth task.
    if (xQueueSend(commands, &command, 0) != pdTRUE) { disconnectRequested=true;server->disconnect(event->conn_handle); }
  }
};

Connections connectionCallbacks;
Security securityCallbacks;
Writes writeCallbacks;
StateReads stateReadCallbacks;

class ControlReads final : public BLECharacteristicCallbacks {
  void onRead(BLECharacteristic* characteristic,ble_gap_conn_desc* peer) override {
    if(peer&&authorizeEncryptedPeer(*peer)&&peer->sec_state.bonded&&controlPageReady&&
       (!controlPageTransaction||controlPageGeneration==generation))return;
    // Only a bounded binary header is touched on the host task. Snapshot/form
    // parsing, allocation, Preferences and lamp/radio work stay on the loop.
    uint8_t denied[LampBleControlWire::Header]{};
    LampBleControlWire::header(denied,0,0,403,0,0,0);
    characteristic->setValue(denied,sizeof(denied));controlPageReady=false;
  }
};
ControlReads controlReadCallbacks;

class OtaWrites final : public BLECharacteristicCallbacks {
 void onWrite(BLECharacteristic* characteristic,ble_gap_conn_desc* peer) override {
  if(!peer||!authorizeEncryptedPeer(*peer)||!peer->sec_state.bonded)return;
  const String value=characteristic->getValue();
  if(!enqueueLampBleUpdate(reinterpret_cast<const uint8_t*>(value.c_str()),value.length(),generation)){
   disconnectRequested=true;server->disconnect(peer->conn_handle);
  }
 }
};
class OtaReads final : public BLECharacteristicCallbacks {
 void onRead(BLECharacteristic* characteristic,ble_gap_conn_desc* peer) override {
  if(peer&&authorizeEncryptedPeer(*peer)&&peer->sec_state.bonded)return;
  uint8_t denied[20]{};denied[0]=1;denied[1]=LampBleUpdateWire::Error;denied[2]=LampBleUpdateWire::Denied;
  characteristic->setValue(denied,sizeof(denied));
 }
};
OtaWrites otaWriteCallbacks;OtaReads otaReadCallbacks;

void cacheControlPage(uint8_t* bytes,size_t size,uint32_t owner){
  if(!controlCharacteristic)return;
  // Overwrite the previous characteristic storage before replacing its value;
  // a prior explicit private invitation must not remain in a cached page.
  uint8_t erased[LampBleControlWire::MaxPage]{};
  controlPageReady=false;
  const size_t previous=controlCharacteristic->getLength();
  if(previous&&previous<=sizeof(erased))controlCharacteristic->setValue(erased,previous);
  controlCharacteristic->setValue(bytes,size);
  controlPageGeneration=owner;
  controlPageTransaction=size>=LampBleControlWire::Header?LampBleControlWire::u16(bytes+1):0;
  controlPageReady=true;
}
void cacheControlMetadata(){
  uint8_t bytes[LampBleControlWire::MaxPage]{};
  const size_t size=lampBleControlMetadata(bytes,sizeof(bytes));
  cacheControlPage(bytes,size,generation);LampBleControlWire::zero(bytes,sizeof(bytes));
}

void updateAdvertising()
{
  auto* advertising = BLEDevice::getAdvertising();
  advertising->stop();
  BLEAdvertisementData data;
  BLEAdvertisementData response;
  data.setFlags(0x06);
  // Outside enrollment, omit the service and name so Find my lamp only lists
  // lamps deliberately put into pairing mode. Saved phones connect by device ID.
  if (pairing) {
    data.setCompleteServices(BLEUUID(SERVICE));
    response.setName(bluetoothName);
  }
  advertising->setAdvertisementData(data);
  advertising->setScanResponseData(response);
  ble_addr_t peers[CONFIG_BT_NIMBLE_MAX_BONDS];
  if (connection == NO_CONNECTION && (pairing || bondedPeers(peers) > 0)) advertising->start();
}

void publish(uint8_t id, uint8_t result, bool acknowledge)
{
  const uint8_t visibleCount = extendedControls ? min(extendedControls.load(), lampAvailableEffectCount()) : 29;
  uint8_t effect[8]; getLampEffectPacket(effect);
  if (effect[1] > visibleCount) effect[1] = 29;
  if (memcmp(effect,lastEffect,sizeof(effect))) {
    memcpy(lastEffect,effect,sizeof(effect)); effectCharacteristic->setValue(effect,sizeof(effect));
    if (secure && extendedControls) effectCharacteristic->notify();
  }
  const auto state = getLampControlState();
  const auto color = getLampColor(state.mode);
  const uint8_t visibleMode = state.mode > visibleCount ? 29 : state.mode;
  const bool changed = lastState[6] != visibleCount || lastState[3] != visibleMode || lastState[4] != state.brightness || lastState[5] != state.power ||
    lastState[12] != color.enabled || lastState[13] != color.r || lastState[14] != color.g || lastState[15] != color.b;
  if (!changed && !acknowledge && lastState[0]) return;
  if (changed) ++revision;
  uint8_t value[16] = {LAMP_PROTOCOL_VERSION, id, result, visibleMode, state.brightness,
    static_cast<uint8_t>(state.power), visibleCount, 255};
  value[12] = color.enabled; value[13] = color.r; value[14] = color.g; value[15] = color.b;
  for (int i = 0; i < 4; ++i) value[8 + i] = revision >> (8 * i);
  memcpy(lastState, value, sizeof(value));
  stateCharacteristic->setValue(value, sizeof(value));
  if (secure && (changed || acknowledge)) stateCharacteristic->notify();
}
} // namespace

void beginLampBluetooth(const String& name)
{
  bluetoothName = name;
  commands = xQueueCreate(8, sizeof(Command));
  if (!commands) return;
  BLEDevice::init(name);
  BLEDevice::setMTU(247);
  if(lampFactoryResetNeedsBondErase()) {
    if(ble_store_clear()!=0 || !completeLampFactoryReset()) {
      Serial.println("Factory reset could not clear phone bonds; retrying.");
      delay(1000);ESP.restart();return;
    }
  }
  BLEDevice::setSecurityCallbacks(&securityCallbacks);
  BLESecurity::setAuthenticationMode(ESP_LE_AUTH_REQ_SC_BOND);
  BLESecurity::setCapability(ESP_IO_CAP_NONE);
  BLESecurity::setKeySize(16);
  BLESecurity::setInitEncryptionKey();
  BLESecurity::setRespEncryptionKey();
  server = BLEDevice::createServer();
  server->setCallbacks(&connectionCallbacks);
  server->advertiseOnDisconnect(false);
  BLEService* service = server->createService(SERVICE);
  auto* command = service->createCharacteristic(COMMAND, BLECharacteristic::PROPERTY_WRITE | BLECharacteristic::PROPERTY_WRITE_ENC);
  auto* identity = service->createCharacteristic(IDENTITY, BLECharacteristic::PROPERTY_READ | BLECharacteristic::PROPERTY_READ_ENC);
  identity->setValue(lampIdentity().c_str());
  catalogCharacteristic = service->createCharacteristic("7b610007-6e2b-4f3d-9a71-28e45c001001", BLECharacteristic::PROPERTY_READ | BLECharacteristic::PROPERTY_READ_ENC);
  catalogCharacteristic->setValue("{}");
  command->setCallbacks(&writeCallbacks);
  stateCharacteristic = service->createCharacteristic(STATE, BLECharacteristic::PROPERTY_READ | BLECharacteristic::PROPERTY_READ_ENC | BLECharacteristic::PROPERTY_NOTIFY);
  stateCharacteristic->setCallbacks(&stateReadCallbacks);
  firmwareCharacteristic = service->createCharacteristic(FIRMWARE, BLECharacteristic::PROPERTY_READ | BLECharacteristic::PROPERTY_READ_ENC | BLECharacteristic::PROPERTY_NOTIFY);
  effectCharacteristic = service->createCharacteristic(EFFECT, BLECharacteristic::PROPERTY_READ | BLECharacteristic::PROPERTY_READ_ENC | BLECharacteristic::PROPERTY_NOTIFY);
  getLampEffectPacket(lastEffect); effectCharacteristic->setValue(lastEffect, sizeof(lastEffect));
  getLampUpdatePacket(lastFirmware);
  firmwareCharacteristic->setValue(lastFirmware, sizeof(lastFirmware));
  // Append new characteristics to preserve existing GATT handles for saved phones.
  wifiCharacteristic = service->createCharacteristic(WIFI_SETUP, BLECharacteristic::PROPERTY_READ | BLECharacteristic::PROPERTY_READ_ENC);
  wifiCharacteristic->setValue("{}");
  centerCharacteristic=service->createCharacteristic("7b610009-6e2b-4f3d-9a71-28e45c001001",BLECharacteristic::PROPERTY_READ|BLECharacteristic::PROPERTY_READ_ENC);
  centerCharacteristic->setValue("{}");
  controlCharacteristic=service->createCharacteristic(CONTROL_RPC,BLECharacteristic::PROPERTY_READ|BLECharacteristic::PROPERTY_READ_ENC);
  controlCharacteristic->setCallbacks(&controlReadCallbacks);
  cacheControlMetadata();
  // Only capability-aware phones use unacknowledged writes for four Data
  // frames. Metadata, Start, Finish and Cancel keep their acknowledged writes.
  auto* otaWrite=service->createCharacteristic(OTA_WRITE,BLECharacteristic::PROPERTY_WRITE|BLECharacteristic::PROPERTY_WRITE_NR|BLECharacteristic::PROPERTY_WRITE_ENC);
  otaWrite->setCallbacks(&otaWriteCallbacks);
  otaStatusCharacteristic=service->createCharacteristic(OTA_STATUS,BLECharacteristic::PROPERTY_READ|BLECharacteristic::PROPERTY_READ_ENC|BLECharacteristic::PROPERTY_NOTIFY);
  otaStatusCharacteristic->setCallbacks(&otaReadCallbacks);
  getLampBleUpdateStatus(lastOtaStatus);otaStatusCharacteristic->setValue(lastOtaStatus,sizeof(lastOtaStatus));
  // NimBLE creates the notification subscription descriptor automatically.
  publish(0, 0, false);
  service->start();
  updateAdvertising();
}

void setLampPairingWindow(bool open)
{
  pairing = open && server;
  pairingStarted = millis();
  // Make room for a new phone if the owner opens pairing while one is connected.
  if (pairing && connection != NO_CONNECTION) {
    disconnectRequested=true;
    secure = false;
    ++generation;
    extendedControls = false;
    server->disconnect(connection);
  }
  advertisingDirty = true;
}

bool lampPairingOpen() { return pairing; }
// Stop the visual cue as soon as a radio connection is accepted. Keep the
// enrollment window open until secure bonding finishes; closing it in
// onConnect would reject a new phone's authentication request.
bool lampPairingCueActive() { return pairing && connection == NO_CONNECTION; }
bool lampBluetoothReady() { return BLEDevice::getInitialized() && server; }
String lampBluetoothStatusJson() {
  ble_addr_t peers[CONFIG_BT_NIMBLE_MAX_BONDS];
  return String("{\"enabled\":") + (lampBluetoothReady()?"true":"false") +
    ",\"pairing\":" + (lampPairingOpen()?"true":"false") +
    ",\"cue\":" + (lampPairingCueActive()?"true":"false") +
    ",\"connected\":" + (connection!=NO_CONNECTION?"true":"false") +
    ",\"secure\":" + (secure?"true":"false") +
    ",\"knownPeer\":" + (knownPeer?"true":"false") +
    ",\"bonds\":" + bondedPeers(peers) +
    ",\"connects\":" + connects.load() + ",\"authentications\":" + authentications.load() +
    ",\"lastEncrypted\":" + (lastEncrypted?"true":"false") + ",\"lastBonded\":" + (lastBonded?"true":"false") +
    ",\"writes\":" + writes.load() + ",\"rejectedWrites\":" + rejectedWrites.load() +
    ",\"lastOperation\":" + lastOperation.load() + ",\"lastCommandId\":" + lastCommandId.load() +
    ",\"acknowledgments\":" + acknowledgments.load() + ",\"lastAckId\":" + lastAckId.load() +
    ",\"notifyStatus\":" + lastNotifyStatus.load() + ",\"notifyCode\":" + lastNotifyCode.load() +
    ",\"stateReads\":" + stateReads.load() + ",\"lastReadLength\":" + lastReadLength.load() +
    ",\"stateBytes\":" + (stateCharacteristic?stateCharacteristic->getLength():0) +
    ",\"serviceRefreshes\":" + serviceRefreshes.load() + ",\"lastAuthAccepted\":" + (lastAuthAccepted?"true":"false") +
    ",\"lastRejected\":[" + unsigned(rejectedSecure.load()) + "," + unsigned(rejectedSameConnection.load()) + "," + unsigned(rejectedEncrypted.load()) +
    "],\"lastAuthAt\":" + lastAuthAt.load() + ",\"lastWriteAt\":" + lastWriteAt.load() + ",\"lastDisconnectAt\":" + lastDisconnectAt.load() + "}";
}

void forgetLampPhones()
{
  if (!pairing || !server) return;
  disconnectRequested=true;
  secure = false;
  knownPeer = false;
  ++generation;
  if (connection != NO_CONNECTION) server->disconnect(connection);
  ble_addr_t peers[CONFIG_BT_NIMBLE_MAX_BONDS];
  const int count = bondedPeers(peers);
  for (int i = 0; i < count; ++i) ble_store_util_delete_peer(&peers[i]);
  advertisingDirty = true;
}
bool lampBluetoothHasBonds(){if(!server)return false;ble_addr_t peers[CONFIG_BT_NIMBLE_MAX_BONDS];return bondedPeers(peers)>0;}

void serviceLampBluetooth()
{
  if (!server) return;
  static uint32_t transferGeneration = 0;
  const uint32_t currentGeneration = generation;
  if (transferGeneration != currentGeneration) {
    resetLampWifiSetupTransfer();resetLampBleControlTransfer(currentGeneration);
    cacheControlMetadata();transferGeneration = currentGeneration;
  }
  ble_gap_conn_desc peer{};
  const bool authenticated = connection != NO_CONNECTION && ble_gap_conn_find(connection, &peer) == 0 && authorizeEncryptedPeer(peer);
  if(serviceLampBleControlTransfer(currentGeneration,authenticated&&peer.sec_state.bonded,lampUpdateOwnsResources())||!controlPageReady)cacheControlMetadata();
  serviceLampBleUpdate(currentGeneration,authenticated&&peer.sec_state.bonded);
  uint8_t otaStatus[20];getLampBleUpdateStatus(otaStatus);
  // Restore even an unauthorized cached read; reads never expose a write buffer.
  const bool otaChanged=memcmp(lastOtaStatus,otaStatus,20);
  if(otaChanged)memcpy(lastOtaStatus,otaStatus,20);
  otaStatusCharacteristic->setValue(otaStatus,20);
  if(otaChanged&&authenticated&&peer.sec_state.bonded)otaStatusCharacteristic->notify();
  if(authenticated) {
    // The wrapper registers characteristics by allocation address. Notify a
    // trusted phone once per boot so old ATT handles can be discarded. Keep the
    // peer list exclusively on the loop task, separate from security callbacks.
    bool refreshed=false;
    for(uint8_t i=0;i<refreshedPeerCount;++i)if(ble_addr_cmp(&refreshedPeers[i],&peer.peer_id_addr)==0)refreshed=true;
    if(!refreshed) {
      ble_svc_gatt_changed(0x0001,0xffff);++serviceRefreshes;
      if(refreshedPeerCount<CONFIG_BT_NIMBLE_MAX_BONDS)refreshedPeers[refreshedPeerCount++]=peer.peer_id_addr;
      else refreshedPeers[0]=peer.peer_id_addr;
    }
  }
  const bool paired = pairing && authenticated && peer.sec_state.bonded;
  if (paired || (pairing && millis() - pairingStarted >= 120000)) {
    pairing = false;
    advertisingDirty = true;
  }
  if (advertisingDirty.exchange(false)) updateAdvertising();
  Command command{};
  LampBleControlWire::Frame controlFrame{};
  const bool controlPending=controlCommands.pop(controlFrame);
  bool commandPending=controlPending;
  if(controlPending){command.generation=controlFrame.generation;command.length=controlFrame.length;memcpy(command.bytes,controlFrame.bytes,command.length);}
  else commandPending=xQueueReceive(commands,&command,0)==pdTRUE;
  LampBleControlWire::zero(&controlFrame,sizeof(controlFrame));
  // Bound work per frame; app waits for each application-level acknowledgment.
  if (commandPending && authenticated && command.generation == generation) {
    const uint8_t version = command.bytes[0], id = command.bytes[1], op = command.bytes[2], value = command.bytes[3];
    auto state = getLampControlState();
    uint8_t result = 0;
    if (version != LAMP_PROTOCOL_VERSION || id == 0) result = 1;
    else if (lampIsUpdating() && op != 5 && op != 12&&!LampBleControlWire::operation(op)) result = 3;
    else {
      switch (op) {
        case 1: if (value > 1) result = 2; else setLampControl(state.mode, state.brightness, value); break;
        case 2: if (!setLampControl(state.mode, value, state.power)) result = 2; break;
        case 3: if (!setLampControl(value, state.brightness, state.power)) result = 2; break;
        case 4: if (value) result = 2; else if (!saveLampDefaults()) result = 4; break;
        case 5: if (value) result = 2; break;
        case 6: if (!setLampColor(value, command.bytes[4], command.bytes[5], command.bytes[6])) result = 2; break;
        case 7: if (!resetLampColor(value)) result = 2; break;
        case 11: if (!extendedControls || !setLampEffectOptions(value, {command.bytes[4],command.bytes[5],command.bytes[6],command.bytes[7],command.bytes[8],command.bytes[9]})) result=2; break;
        case 12: if (value == 1) extendedControls=37; else if (value == 2) extendedControls=38; else if (value == 3) extendedControls=lampAvailableEffectCount(); else result=2; break;
        case 13: if (value < 1 || value > lampAvailableEffectCount()) result=2; else catalogCharacteristic->setValue(lampEffectCatalogEntry(value).c_str()); break;
        case 14: case 15: case 16: case 17: case 18: {
          String response;
          result = lampWifiSetupCommand(command.bytes, command.length, command.generation, response);
          if (!result && !response.isEmpty()) wifiCharacteristic->setValue(response.c_str());
          break;
        }
        case 19: if(value!=LAMP_FACTORY_RESET_CONFIRM)result=2;else if(!requestLampFactoryReset())result=4;break;
        case 20: {
          bool ok=value==3;
          if(value==0)ok=beginLampCenterCalibration();
          else if(value==1||value==2)ok=lampCalibrationCenter()&&finishLampCalibration(value==1);
          if(!ok)result=2;else centerCharacteristic->setValue(lampCenterCalibrationJson().c_str());
          break;
        }
        case 21: {
          const uint16_t position=uint16_t(value)|uint16_t(command.bytes[4])<<8;
          if(!lampCalibrationCenter()||!position||position>lampCalibrationMaximum())result=2;
          else {moveLampCalibration(position);centerCharacteristic->setValue(lampCenterCalibrationJson().c_str());}
          break;
        }
        case 22: case 23: case 24: case 25: {
          if(!peer.sec_state.bonded){result=3;break;}
          uint8_t reply[LampBleControlWire::MaxPage]{};size_t replySize=0;
          result=lampBleControlCommand(command.bytes,command.length,command.generation,reply,sizeof(reply),replySize);
          if(command.generation!=generation||!secure){
            resetLampBleControlTransfer(generation);cacheControlMetadata();result=3;
          }else if(replySize)cacheControlPage(reply,replySize,command.generation);
          LampBleControlWire::zero(reply,sizeof(reply));
          break;
        }
        case 8: if (value) result = 2; else if (!requestLampUpdateCheck()) result = 3; break;
        case 9: if (value) result = 2; else if (!requestLampUpdateInstall()) result = 3; break;
        case 10: if (value > 1) result = 2; else if (!setLampAutoUpdate(value)) result = 4; break;
        default: result = 2;
      }
    }
    if(!LampBleControlWire::operation(op)||command.generation==generation){
      ++acknowledgments;lastAckId=id;publish(id,result,true);
    }else publish(0,0,false);
  } else {
    // Detect changes from the knob and HTTP without making those paths know BLE.
    publish(0, 0, false);
  }
  LampBleControlWire::zero(&command,sizeof(command));
  // A legacy update command above may have just reserved TLS resources. Free
  // a prior full snapshot now, before serviceLampUpdater runs in this loop.
  if(lampUpdateOwnsResources()&&serviceLampBleControlTransfer(generation,secure&&peer.sec_state.bonded,true))cacheControlMetadata();
  uint8_t firmware[20]; getLampUpdatePacket(firmware);
  if (memcmp(firmware, lastFirmware, sizeof(firmware))) {
    memcpy(lastFirmware, firmware, sizeof(firmware));
    firmwareCharacteristic->setValue(firmware, sizeof(firmware));
    if (secure) firmwareCharacteristic->notify();
  }
}
#else
void beginLampBluetooth(const String&) {}
void serviceLampBluetooth() {}
void setLampPairingWindow(bool) {}
bool lampPairingOpen() { return false; }
bool lampPairingCueActive() { return false; }
String lampBluetoothStatusJson() { return "{\"enabled\":false,\"pairing\":false,\"cue\":false,\"connected\":false,\"secure\":false,\"knownPeer\":false,\"bonds\":0}"; }
bool lampBluetoothReady() { return false; }
bool lampBluetoothHasBonds() { return false; }
void forgetLampPhones() {}
#endif
