jammendolia/CoolLamp/tests/control-http-adapter.py

"""Run the real BLE/HTTP adapter and extracted production handlers together."""
import json
import pathlib
import subprocess
import tempfile
import unittest
from host_compiler import SANITIZERS

ROOT = pathlib.Path(__file__).resolve().parents[1]


def function(source, signature):
    start = source.index(signature)
    cursor = source.index('{', start)
    depth = 0
    quote = None
    while cursor < len(source):
        char = source[cursor]
        if quote:
            if char == '\\':
                cursor += 2
                continue
            if char == quote:
                quote = None
        elif char in '\"\'':
            quote = char
        elif source.startswith('//', cursor):
            cursor = source.index('\n', cursor)
            continue
        elif source.startswith('/*', cursor):
            cursor = source.index('*/', cursor) + 2
            continue
        elif char == '{':
            depth += 1
        elif char == '}':
            depth -= 1
            if not depth:
                return source[start:cursor + 1]
        cursor += 1
    raise ValueError('Unclosed function ' + signature)


def registration(source, route, method='POST'):
    start = source.index('  lampServer.on("' + route + '", HTTP_' + method)
    end = source.index('\n  lampServer.on(', start + 1)
    return source[start:end]


class ControlHttpAdapterTests(unittest.TestCase):
    def test_real_handlers_authentication_configuration_snapshot_and_cleanup(self):
        source = (ROOT/'LampNetwork.ino').read_text()
        sync_source = (ROOT/'LampSync.cpp').read_text()
        effect_names = source[source.index('const char* const effectNames[]'):source.index('static_assert(sizeof(effectNames)')]
        definitions = '\n'.join(function(source, signature) for signature in [
            'String jsonText(', 'bool authorizedLampRequest(', 'bool readNumber(', 'String lampEffectCatalogEntry(',
            'void sendLampState()', 'LampControlReply lampControlRequest(',
            'String lampControlSnapshotJson()', 'void saveLampConfiguration()'])
        audio_source = (ROOT/'LampAudio.cpp').read_text()
        audio_settings = '\n'.join(function(audio_source, signature) for signature in [
            'bool lampHasMicrophone()', 'bool saveLampMicrophoneInstalled(', 'bool saveLampAudioConfiguration('])
        sync_json = function(sync_source, 'String lampSyncJson()')
        quote_json = function(sync_source, 'String quote(')
        routes = '\n'.join(registration(source, route) for route in ['/api/sync', '/api/sync/scene', '/api/sync/invite', '/api/name', '/api/style'])
        routes += '\n' + registration(source, '/api/effects', 'GET')
        setup = r'''
#include <cassert>
#include <cstring>
#include <fstream>
#include <iostream>
#include "LampControlHttpAdapter.h"
#include "LampConfig.h"
#include "LampFactory.h"
#include "LampGeometry.h"
#include "LampStyle.h"
#include "LampAudio.h"
#include "LampSyncProtocol.h"
#include "Preferences.h"
LampControlHttpAdapter lampServer(80);
LampSettings lampSettings;
String lampToken="http-session-token-private",lampHost="coollamp-test",lampName="Test lamp";
uint32_t apLastActivity=0,restartAt=0;uint32_t millis(){return 1000;}
bool following=false,ownsUpdate=false,remoteBusy=false,wifiSetupBusy=false,otaActive=false,mdnsStarted=false,colorsSaved=true;
bool lampSyncFollowing(){return following;}bool lampUpdateOwnsResources(){return ownsUpdate;}
bool lampRemoteUpdateBusy(){return remoteBusy;}bool lampWifiSetupBusy(){return wifiSetupBusy;}
bool resetPending=false;bool lampFactoryResetPending(){return resetPending;}
bool lampIsUpdating(){return ownsUpdate;}bool saveLampColors(){return colorsSaved;}
bool installed=true;uint8_t gain=17;uint16_t gate=23,scale=250;
uint16_t NUM_LEDS=205,lampMidpoint=102;uint8_t Mode=4,Brightness=55;bool PowerOn=true;
constexpr uint8_t MODE_FIRE=4,LAMP_PROTOCOL_VERSION=1,LAMP_BASE_EFFECT_COUNT=38;
uint8_t lampAvailableEffectCount(){return 47;}
struct Color {uint8_t enabled=1,r=70,g=220,b=255;};
Color getLampColor(uint8_t){return {};}
struct Options {uint8_t speed=60,intensity=85,dual=1,r=255,g=65,b=170;};
Options getLampEffectOptions(uint8_t){return {};}
struct RGB {uint8_t r=70,g=220,b=255;};
RGB fountainPaletteColor(unsigned){return {};}RGB renderVuColor(unsigned){return {};}
bool lampCalibrationActive(){return false;}bool lampCalibrationCenter(){return false;}unsigned lampCalibrationPosition(){return 134;}
struct {bool enabled=true,random=false;uint8_t category=0;uint32_t seconds=30;} lampRotation;
String lampUpdateJson(){return "{\"version\":\"1.10.0\",\"phase\":0,\"progress\":0,\"error\":0,\"wifi\":false,\"available\":false,\"automatic\":false,\"latest\":\"1.10.0\"}";}
String lampAudioJson(){return String("{\"installed\":")+(installed?"true":"false")+",\"gain\":"+String(gain)+",\"gate\":"+String(gate)+",\"scale\":"+String(scale)+"}";}
constexpr int WL_CONNECTED=3;
struct Address {String toString(){return "0.0.0.0";}};
struct {int status(){return 0;}Address localIP(){return {};}Address gatewayIP(){return {};}Address dnsIP(int){return {};}} WiFi;
struct {void addServiceTxt(const char*,const char*,const char*,const String&) {}} MDNS;
using namespace LampSyncWire;
struct {uint8_t role=1;char leader[13]="aabbccddeeff",key[33]="0123456789abcdef0123456789abcdef";} config;
struct Peer {Packet info{};bool joined=false;uint32_t seen=1000,subscribed=1000;bool udpKnown=false,radioKnown=true;uint32_t udpSeen=1000,radioSeen=1000;Address ip;uint8_t radioChannel=6;} peers[8];
struct {uint8_t count=9;char order[9][13]{};} sceneConfig;
char identity[13]="aabbccddeeff";
bool paused=false,followingRadio=true,started=false,serviceBlocked=false;
uint32_t receivedPackets=20,discoveries=8,authFailures=0,subscriptionsSent=8,framesReceived=20,clockDrops=0;
namespace LampEspNow {
struct Status {bool active=true,suspended=false,seeking=false;uint8_t channel=6;uint32_t received=10,receiveDropped=0,sent=20,sendFailed=0,sendDropped=0,channelChanges=0;};
Status status(){return {};}
}
Visual lampGroupVisual(){Visual visual{};visual.scene=32;visual.count=9;visual.sceneSpeed=60;visual.sceneIntensity=85;return visual;}
unsigned syncMutations=0,sceneMutations=0,pauseMutations=0,resumeMutations=0;
bool configureLampSync(uint8_t role,const String&,const String&){++syncMutations;return role<=2;}
bool configureLampScene(uint8_t,uint8_t,uint8_t,const uint8_t*,const uint8_t*){++sceneMutations;return config.role==1;}
void pauseLampSync(){++pauseMutations;}void resumeLampSync(){++resumeMutations;}
String lampSyncInvite(){return String("CL1-")+config.leader+"-"+config.key;}
String lampSyncJson();
'''
        main = r'''
LampSettings stored(){LampSettings value{};const auto& bytes=Preferences::storage.at("settings");assert(bytes.size()==sizeof(value));memcpy(&value,bytes.data(),sizeof(value));return value;}
void initial(){
 lampSettings={};lampSettings.version=1;lampSettings.ledCount=134;lampSettings.milliAmps=500;lampSettings.brightness=88;lampSettings.startupMode=4;
 strcpy(lampSettings.ssid,"Saved network");strcpy(lampSettings.wifiPassword,"wifi-password-private");strcpy(lampSettings.adminPassword,"admin-password-private");
 strcpy(sceneConfig.order[0],identity);
 for(unsigned i=0;i<8;++i){auto& peer=peers[i];snprintf(peer.info.sender,13,"%012x",i+1);peer.info.role=2;peer.info.microphone=1;memset(peer.info.name,'N',48);peer.info.name[48]=0;peer.joined=true;strcpy(sceneConfig.order[i+1],peer.info.sender);}
 Preferences prefs;assert(prefs.putBytes("settings",&lampSettings,sizeof(lampSettings))==sizeof(lampSettings));
}
int main(int argc,char** argv){
 initial();
 lampServer.on("/api/state",HTTP_GET,sendLampState);
 lampServer.on("/api/config",HTTP_POST,saveLampConfiguration);
 registerRoutes();
 beginLampStyle();assert(lampStyleCode()==0);
 // Classification is authenticated metadata, even for a current follower.
 const auto hardwareBefore=Preferences::storage.at("settings");
 lampServer.arguments={{"style","3"}};lampServer.headers={{"X-Lamp-Token",lampToken}};lampServer.httpAuthorized=false;
 lampServer.invokeHttp("/api/style",HTTP_POST);assert(lampServer.responseStatus==401&&lampStyleCode()==0);
 lampServer.httpAuthorized=true;lampServer.headers["X-Lamp-Token"]="bad";
 lampServer.invokeHttp("/api/style",HTTP_POST);assert(lampServer.responseStatus==403&&lampStyleCode()==0);
 following=true;auto styleResult=lampControlRequest(LampControlEndpoint::Style,true,"style=3");
 assert(styleResult.status==200&&lampStyleCode()==3&&!restartAt&&Preferences::storage.at("settings")==hardwareBefore&&Mode==4&&Brightness==55&&PowerOn);
 following=false;
 for(const char* body:{"","style=-1","style=4","style=1x","style=3&style=1"})assert(lampControlRequest(LampControlEndpoint::Style,true,body).status==400);
 Preferences::failWrites=true;assert(lampControlRequest(LampControlEndpoint::Style,true,"style=1").status==500&&lampStyleCode()==3);Preferences::failWrites=false;
 resetPending=true;assert(lampControlRequest(LampControlEndpoint::Style,true,"style=1").status==409&&lampStyleCode()==3);resetPending=false;
 wifiSetupBusy=true;assert(lampControlRequest(LampControlEndpoint::Style,true,"style=1").status==409&&lampStyleCode()==3);wifiSetupBusy=false;
 otaActive=true;assert(lampControlRequest(LampControlEndpoint::Style,true,"style=1").status==409&&lampStyleCode()==3);otaActive=false;
 ownsUpdate=true;assert(lampControlRequest(LampControlEndpoint::Style,true,"style=1").status==409&&lampStyleCode()==3);ownsUpdate=false;
 beginLampStyle();assert(lampStyleCode()==3);
 const String hardware="leds=205&milliamps=700&brightness=88&mode=4";
 // Real HTTP authentication/token checks still run after a private BLE context.
 lampServer.arguments={{"leds","205"},{"milliamps","700"},{"brightness","88"},{"mode","4"},{"ssid","Saved network"},{"control","true"}};
 lampServer.headers={{"X-Lamp-Token",lampToken}};lampServer.httpAuthorized=false;
 const auto original=Preferences::storage["settings"];
 lampServer.invokeHttp("/api/config",HTTP_POST);assert(lampServer.responseStatus==401&&Preferences::storage["settings"]==original);
 lampServer.httpAuthorized=true;lampServer.headers["X-Lamp-Token"]="incorrect";
 lampServer.invokeHttp("/api/config",HTTP_POST);assert(lampServer.responseStatus==403&&Preferences::storage["settings"]==original);
 const int authBefore=lampServer.authCalls;
 auto result=lampControlRequest(LampControlEndpoint::Config,true,hardware);
 assert(result.status==200&&lampServer.authCalls==authBefore&&!lampServer.controlActive());
 auto next=stored();assert(next.ledCount==205&&next.milliAmps==700&&next.brightness==88&&next.startupMode==4);
 assert(!strcmp(next.ssid,"Saved network")&&!strcmp(next.wifiPassword,"wifi-password-private")&&!strcmp(next.adminPassword,"admin-password-private"));
 assert(lampSettings.ledCount==134&&lampSettings.brightness==88&&lampSettings.startupMode==4);
 assert(lampServer.arg("ssid")=="Saved network"&&lampServer.arg("leds")=="205");
 assert(lampServer.header("X-Lamp-Token")=="incorrect"&&lampServer.uri()=="/api/config");
 assert(lampServer.authenticate("lamp","ignored"));
 // Startup defaults change only when the caller explicitly chooses them.
 result=lampControlRequest(LampControlEndpoint::Config,true,"leds=205&milliamps=700&brightness=99&mode=8");
 assert(result.status==200);next=stored();assert(next.brightness==99&&next.startupMode==8&&!strcmp(next.ssid,"Saved network"));
 // Optional hardware microphone configuration uses the actual production
 // settings helper. Its saved change applies only at reboot, retaining tuning.
 assert(Preferences::storage.count("audioV2")==0);
 assert(saveLampMicrophoneInstalled(true));const auto originalAudio=Preferences::storage.at("audioV2");
 const auto originalHardware=Preferences::storage.at("settings");
 const auto microphoneCalls=Preferences::audioWrites;
 result=lampControlRequest(LampControlEndpoint::Config,true,hardware);
 assert(result.status==200&&Preferences::audioWrites==microphoneCalls&&Preferences::storage.at("audioV2")==originalAudio);
 restartAt=0;const auto validationWrites=Preferences::writes;
 for(const char* value:{"","-1","2","1x","true"}){
  result=lampControlRequest(LampControlEndpoint::Config,true,hardware+"&microphoneInstalled="+value);
  assert(result.status==400&&Preferences::writes==validationWrites&&!restartAt&&lampHasMicrophone());
 }
 Preferences::failKey="audioV2";
 result=lampControlRequest(LampControlEndpoint::Config,true,hardware+"&microphoneInstalled=0");
 assert(result.status==500&&Preferences::storage.at("audioV2")==originalAudio&&!restartAt);
 Preferences::failKey="";
 result=lampControlRequest(LampControlEndpoint::Config,true,hardware+"&microphoneInstalled=0");
 assert(result.status==200&&restartAt==2200&&lampHasMicrophone());
 const auto disabledAudio=Preferences::storage.at("audioV2");assert(disabledAudio.size()==7&&disabledAudio[0]==2&&disabledAudio[1]==0);
 for(unsigned i=2;i<7;++i)assert(disabledAudio[i]==originalAudio[i]);
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
