jammendolia/CoolLamp/(commit log)

2026-09-16 Add per-effect custom colors and staged setup feedback
2026-09-16 Fix OTA header allocation crash with bounded HTTPS streaming
    [LampUpdate.cpp, UpdateHttp.cpp, UpdateHttp.h, UpdateHttpHeaders.h, update-http.cpp]
2026-09-16 Pin OTA installs to the offered release and bypass stale manifests
2026-09-24 Add a persistent adjustable center for asymmetric lamps
    Expose Center after LED in Wi-Fi app settings and the lamp web page. Apply and save without reboot; zero retains automatic centering. Scale split fire, rain, comet collision, droplets, heartbeat, and Sound meter around the chosen boundary. Preserve existing settings and GPIO assignments.
    Validation: 33 mobile tests pass on the publishing snapshot; app and ESP32-C3 builds pass; sanitized effect, geometry and knob tests pass, including asymmetric and 1–1024 LED strips. Firmware flashed with hash verification.
    [Atmosphere.ino, AudioEffects.ino, CoolLamp.ino, FireSplit.ino, LampGeometry.cpp, LampGeometry.h, LampKnob.ino, LampNetwork.ino]
2026-09-24 Hold brief audio peaks for rendering and expose a noise-gate slider
    Keep higher input levels visible for 80 ms so short transients survive frame scheduling and attack smoothing. Preserve instantaneous RMS/peak diagnostics and existing stale-input handling. Match the noise-gate UI to sensitivity and scale controls.
    Validation: sanitizer audio tests cover hold expiry, retriggering, clock wrap and render timing. All 33 mobile tests, microphone page checks, app build and ESP32-C3 build pass.
    [AudioAnalysis.h, LampAudio.cpp, audio.cpp]
2026-09-24 Add five frequency-reactive effects with shared three-band analysis
    Add Spectrum Rise, Bass Launch, Spectral Embers, Beat Bloom, and Three-band Fountain as IDs 41–45. Use fixed-point band analysis and attack detection, bounded pulse storage, saved asymmetric centers, and customizable spectral colors. Preserve existing two-effect audio settings on upgrade and keep microphone-free catalogs at 38 effects.
    Validation: ESP32-C3 and app builds; 33 mobile tests on publishing snapshot; sanitizer tone, full-scale, onset, persistence and rendering tests; control and knob catalog tests. Firmware 1.6.0 flashed with hash verification.
    [AudioEffects.ino, AudioSpectrum.h, CoolLamp.ino, LampAudio.cpp, LampAudio.h, LampColors.ino, LampControl.h, LampNetwork.ino]
2026-09-24 Redesign active-effect settings with Light, Motion and Sound panes
    Give each active effect a focused settings card with behavior-specific controls, a compact effect chooser, clear palette states, and shared audio sliders in its Sound tab. Keep only microphone presence in advanced audio settings. Add authenticated live audio tuning in firmware 1.6.1 while retaining older-firmware fallback.
    Refresh typography, graphite and lavender surfaces, slider readouts, touch targets, safe-area navigation and keyboard tabs. Preserve draft audio edits across polling and effect changes.
    Validation: 36 app tests pass on publishing snapshot; app and ESP32-C3 builds pass; Chromium checks cover effect switchi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
    [LampAudio.cpp, LampAudio.h, LampNetwork.ino]
2026-09-26 Release firmware 1.6.4: reject measured room noise before audio gain control
    [AudioAnalysis.h, LampAudio.cpp, LampAudio.h, audio.cpp]
2026-09-26 Release 1.6.5: rainbow ember sparks and power-aware Sound Glow
2026-10-03 Fix saved-lamp switching after connection and test separate group roles
2026-10-03 Release 1.8.0: group scenes, effect rotation, LED sizing and session discovery
2026-10-05 Fix portable scene index comparison; skip app uploads for firmware-only changes
    [LampGroupScenes.h]
2026-10-05 Make lamp and group power controls prominent and usable on followers
2026-10-06 Add Bluetooth Wi-Fi provisioning, lamp recovery, and center calibration; release 1.9.1
2026-10-06 Clarify reset cleanup control flow for strict GCC release checks
    [LampFactoryReset.cpp]
2026-10-06 Add managed iPhone pairing and recovery; fix BLE reconnects; release 1.9.2
    [LampBluetooth.cpp]
2026-10-06 Fix authorized Bluetooth handoff and reconnect; improve Wi-Fi setup and diagnostics
    [CoolLamp.ino, LampBluetooth.cpp, LampBluetooth.h, LampNetwork.ino, LampWifiSetup.h, LampWifiSetup.ino, audio-usb.py]
2026-10-06 Use resolved iPhone Wi-Fi addresses and publish responsive C3 connection fixes
    [LampNetwork.ino, diagnostics.py]
2026-10-06 Checkpoint CoolLamp source and hardware for Windows migration
    Preserve current app and firmware source, hardware schematics and wiring
    images, CAD fit studies, pending TLS build changes, and development handoff.
    Exclude generated example builds and local workstation session files.
    Validation: 97 mobile tests pass, firmware build succeeds, and schematic
    netlist check passes. Smaller TLS buffers remain pending production/device
    validation; this checkpoint does not publish firmware or TestFlight.
    [CoolLamp-RevA.kicad_sch, insert-concept.scad, parts-review.csv, shared-mount-study.scad]
2026-10-07 Prepare firmware 1.9.5 with temperature diagnostics and room audio scenes
2026-10-07 Discover group coordinators and join without switching lamps
2026-10-09 Add clear per-card power controls and put group power first
2026-10-09 Record app 36 power controls and observed firmware installations
2026-10-09 Prepare trusted cross-group ESP-NOW firmware relay candidate
2026-10-10 Show continuous lighting over the dark Corkscrew frame
2026-10-10 Match lamp settings gear and power control sizing
2026-10-10 Keep lamp power status text readable in both themes
2026-10-11 Allow verified Bluetooth firmware recovery without full settings
    Use a restricted saved-target update connection with protected short reads,
    no settings/catalog/provisioning dependency and owner fences for all transfers.
    Keep identity, artifact, uncertain-route and one-shot commit checks intact.
    Scope iPhone initialization to the target, retain ordinary control validation,
    and exercise production acquisition/initializer/sender failure boundaries.
    Native publication and physical wireless update acceptance remain pending.
2026-10-11 Recover wireless updates with durable intent and protected result checks
    Release Bluetooth while downloading the pinned artifact, then acquire a
    fresh target connection. Journal safety boundaries before firmware writes
    and Wi-Fi POSTs. Reconcile possible execution without route replay, retain
    legacy uncertainty across app termination, and report acknowledged lamp
    progress separately from phone download. Share safeguards across card,
    advanced Bluetooth and fleet entry points.
2026-10-11 Keep explicit retries on protected phone transfer after an unsent attempt
    Avoid repeating the failed Wi-Fi check after a confirmed zero-image result.
    Keep automatic-ready receivers pending, isolate update preflight from normal
    settings polling, preserve safe failure-stage evidence, and retain legacy
    receipts across multiple interrupted checks. Exercise production coordinators,
    real decoded firmware flags and read-only diagnostic UI.
2026-10-12 Show persistent progress while opening lamp settings
    Open a named, cancellable loading sheet immediately from the lamp gear and
    keep chooser progress visible above the inventory. Preserve verified Wi-Fi
    priority, scoped target ownership, bounded recovery and encryption. Reuse the
    confirmed first BLE response page. Carry tested update receipt fencing and
    negotiated sound/path controls, source cues and optional setup guides.
    Validated local mobile handlers and production build; physical/native acceptance
    remains a separate gate. This commit contains no firmware or signing material.
2026-10-12 Retry transient busy Settings reads within a bounded target connection
    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
2026-10-12 Show verified lamp update progress in Settings
    Show the receiving model, written percentage and update stage in Settings.
    Explain foreground-transfer stops without discarding uncertain receipts.
    remains a separate gate. This commit contains no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
2026-10-12 Keep group power controls in the card layout
    remains a separate gate. This commit contains no fi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
